IJMOK/StairTreeChoir/README.md

# Stair Tree Choir

Fourteen lip-syncing pixel Christmas trees cut from old spiral-stair oak treads. Each tree has its own ESP32 (WLED); each site has one Pi running FPP that plays the audio and streams the frames over Wi-Fi.

The project brief, decisions and milestones are in [CLAUDE.md](CLAUDE.md). The parts list is in [docs/bom.md](docs/bom.md), the step-by-step build in [docs/build-guide.md](docs/build-guide.md) and the tests in [docs/test-checklist.md](docs/test-checklist.md). What lives where, in this repo and in the xLights show folder, is in [docs/folders.md](docs/folders.md).

## Quick start

```
python -m venv .venv
.venv/Scripts/python -m pip install -r requirements.txt
.venv/Scripts/python -m pip install -r requirements-cad.txt   # optional: the STEP files for CAM
.venv/Scripts/python -m tools.build     # regenerate data/ and cad/
.venv/Scripts/python -m pytest -q
```

Edit `data/blank.json` (the tread outline) or the parameters in `tools/tree_layout.py`, then rebuild. Never edit generated files by hand.
