IJMOK/StairTreeChoir/electronics/README.md

# Tree controller and site wiring (M4)

One controller per tree: an ESP32 dev board running WLED, a 74AHCT125 level shifter and a Mini560 5V buck on a 5×7cm prototype board, in a printed L base + wrap-round cover (`enclosure/tree-box.scad`) on spacers on the back of the tree. The board takes 12V and gives out one 5V data line. The pixels' own 12V never runs through the board.

- [tree-controller-board.svg](tree-controller-board.svg): where every part goes, plus the joins on the underside (mirrored, as you see it when soldering).
- [connections.md](connections.md): the same as a list: every part's holes, and every join with its hole names.

Both are generated by `tools/gen_controller.py` (`make all`). Change the generator, not the files.

## Schematic

```
   (fused 3A at the site box)
12V flex + ───────────────┬──────────────────────────────► pixel string +12V (xConnect)
(SP16)                    │                    Wago 221
                          │
                          └── Mini560 IN+ (wired)            Mini560 OUT+ (90° header) ── 5V rail
12V flex − ───────────────┬──────────────────────────────► pixel string GND
                          └── Mini560 IN− (wired)            Mini560 OUT− (90° header) ── GND rail

5V rail ── ESP32 5V (J2.19) ── U1.14 VCC ── C1 100µF ── C2 0.1µF (at U1) ── GND rail

ESP32 IO16 (J3.12) ──┬── U1.2 (1A)      U1.3 (1Y) ── R1 33Ω ── JD DATA ──► pixel string DATA
                     └── R2 10k ── GND
U1.1 (1/OE) ── GND                       (channel 1 always enabled)
U1.4, 5, 9, 10, 12, 13 ── GND            (spare channels tied off)
U1.6, 8, 11 ── open                      (spare outputs)
ESP32 GND (J3.1) ── GND rail
```

Why each part is there:
- **74AHCT125**: the ESP32 gives 3.3V logic; WS2811 pixels on 12V want close to 5V. An AHCT part powered at 5V reads 3.3V as a clean high. Soldered in (no sockets, Rob 28 Oct 2026), so check the 5V rail before it goes in.
- **R1 33Ω**: damps ringing on the data lead.
- **R2 10k pull-down**: holds the data line low while the ESP32 boots, so the tree doesn't flash random colours at power-on.
- **C1 100µF, C2 0.1µF**: bulk and local decoupling for the 5V rail.
- **GPIO16**: not a boot strapping pin, works with WLED's LED output, and is what the M0 prototype ran on.
- **GPIO 5, 18, 19, 23 stay free.** They are the ESP32's usual SPI pins for a micro-SD card. If Wi-Fi streaming proves too jittery, a £1 SD breakout wired there keeps the ESPixelStick FPP Remote option open (M0 decision) without new boards.

## Inside the box

- 12V comes in through an SP16 panel socket in the base's shelf (rear nut, firing down); the run from the site box ends in the SP17 cable plug that screws onto it. Short tails go from the socket to the Wagos. It is already fused (3A) at the site box, where the run starts, so the fuse protects the flex as well as the tree. There is no fuse in the tree box.
- Two Wago 221-413 lever connectors split the supply: one joins +12V to the pixel string and to the Mini560's IN+, the other joins GND the same way. No 12V reaches the board. The pixel current (about 2.3A at full white) stays on 18AWG wire and the Wagos, never on the prototype board.
- The pixel lead leaves through the PG7 gland in the base's shelf, as a short round tail ending in an xConnect plug, where it meets the tree's own lead. Its data wire goes to JD DATA. JD GND is spare: fit the optional TVS diode across JD (DATA to GND) if you use one.
- The Mini560 stands on its OUT end at the column A edge (Rob, 30 Oct 2026), on a 90 degree header in column C: OUT+ into C4 and C5, OUT- into C8 and C9, using both pads of each pair for strength. That assumes the pads sit on the 2.54 grid: check before soldering. Its IN end, now at the top, is wired directly from the Wagos.
- The ESP32 and U1 are soldered straight in (no sockets, Rob 28 Oct 2026); a dead one means a desolder or a new board.
- **Antenna**: the WROOM-32U has a U.FL socket on the module. Use a U.FL to RP-SMA bulkhead pigtail and a small dipole on the base's shelf, firing down, hinged out clear of the box and the plug. 30mm of wet oak between the antenna and the router costs signal, so put the box on the side of the tree that faces the router where you can.

**Confirmed from Rob's photos (30 and 31 Oct 2026):** the board is 24×18 holes; the ESP32 clone's pin order matches J2/J3 and its header rows are 10 holes apart (25.4mm). Seen from the component side with the antenna end left, J3 (GND, IO23 … IO16 … CLK) is the top row, row 3, and J2 (3V3 … 5V) is the bottom row, row 13. The drawing had these swapped until 31 Oct 2026, a mirror image that can't be built: on the first board that put the GND wire on 3V3 and the 5V wire on CLK. Fix a board wired to the old list before it's ever powered.

**Unverified until the parts arrive:**
- xConnect wire colours (which is data). Check against the arrows on the string and with a meter before connecting anything.
- The Mini560's pad spacing, and which end is IN (check before any power: 12V on OUT kills it).

## Power and USB: never both

Espressif's DevKitC guide says to power the board from exactly one source: USB, *or* the 5V pin, *or* the 3V3 pin. On this board the 5V pin is always fed by the Mini560, so:
- update WLED over Wi-Fi (Config → Security & Updates → Manual OTA), which needs no cable;
- if you must use USB, unplug the 12V first.

## Building and testing one board

1. Solder the terminals and the passives. Don't fit the ESP32, U1 or the Mini560 yet.
2. Do the underside joins from connections.md, ticking them off. Bridges are a solder blob between neighbouring holes; everything else is insulated wire.
3. Continuity check: 12V, 5V and GND are not shorted to each other. No 12V on the board at all: it reaches only the Mini560's IN pads, by wire from the Wagos.
4. Fit the Mini560 on its 90 degree header, OUT end down. Bench supply at 12V, current limit 200mA, into its IN pads. Check 5.0V (±0.1V) at the J2.19 and U1.14 holes. A Mini560 of the wrong voltage version shows here, before it can kill an ESP32.
5. Power off. Solder in U1 (notch to the right, towards R1) and the ESP32 on its own pins (antenna end left). Power on: the ESP32's LED lights and WLED joins Wi-Fi; current should sit under 150mA at 12V.
6. Connect the pixel string through the Wagos and JD. First-light test in WLED (solid red, then green, then blue) to confirm the colour order; then the xLights test chase to confirm node 1 and the wiring order match the model.

Full-white current per tree and the soak test belong in docs/test-checklist.md (M6).

## Site wiring

Decided 26 Oct 2026 (Rob): one enclosed Mean Well LRS PSU per site (Site A uses Rob's S-400-12 instead, 30 Oct 2026), inside the site box (a DRiBOX Large), star-wired from it; no outdoor PSUs. **Per-site tables and diagrams: [site-wiring.md](site-wiring.md)** (generated from data/sites.json). Drawings of how it all connects and where each part sits in the site box and tree box: [docs/wiring.html](../docs/wiring.html) (open it in a browser).

```
Mains (RCD socket) ── plug lead (3A fuse) ──┐
                    Site box (DRiBOX Large) │
                      PSU (A: S-400-12)            ── 12V ─┬─ 3A fuse ── 2-core flex ──◄► Tree box ── pixels   (one run per tree)
                                                            ├─ 3A fuse ── 2-core flex ──◄► Tree box ── pixels
                                                            ├─ 2A fuse ── site router
                                                            └─ 3A fuse ── 12V→5V buck ── Pi (FPP) ── USB sound card ── PAM8610 ══ speaker pair (L, R)
                                                                                          │ Ethernet
                                                                                     Site router ·····Wi-Fi·····► every tree's ESP32 (DDP)
                                                                         ◄► = SP16/SP17 2-pin screw-terminal aviation connector
```

- One LRS per site, the smallest that carries it at no more than 90% with every tree at its cap, plus the player (1.5A) and the router (1A): Site A LRS-200-12 (17A) at 15.1A, B LRS-150-12 at 10.9A, C and D LRS-100-12 at 6.7A. One spare LRS-200-12 covers any site. Enclosed and fanless; it sits at the top of the plate with air round it, and its mains terminals are under a printed cover.
- Each tree's WLED brightness limiter (`ledma` 25, `maxpwr` 2120 incl. WLED's 120mA ESP allowance; tools/gen_site_config.py) holds its pixels to 2A, so a tree draws 2.1A whatever a sequence does (2.3A would be full white). Check it with a meter at the M0 bench test.
- Voltage drop: 2.1A over 5m of 0.75mm² flex (10m of conductor, ~0.23Ω) is about 0.5V, so a tree sees ~11.5V; fine for 12V pixels. The generator moves a run to 1.5mm² past about 7m.
- The fuse (a blade fuse in the site box's fuse box) sits where each run starts, so it protects the flex (a fuse at the tree end would not). 0.75mm² flex is good for ~6A. 3A fuses (Rob, 26 Oct 2026): a tree can't draw more than 2.3A even with no limiter, and the SP17 connectors are 10A.
- Mains reaches only the PSU's covered terminals, on its own lead; never a printed box. The player runs off a Mini560 (5V) after its 3A fuse: Site A's Pi 3 needs 2.5A at most. A Pi 5 would need 5A.
