IJMOK/StairTreeChoir/docs/folders.md

# Where things are

## This repo

"Generated" means `python -m tools.build` (or the named tool) writes it: change the input and rebuild, never edit it by hand.

| Folder | What's in it | Edited by |
|---|---|---|
| `CLAUDE.md`, `README.md` | Project brief and decisions; quick start | hand |
| `cad/` | STEP solids for CAM in NX (tree, fixture plate, assembly); `printed/` every printed part as a STEP solid, as fitted; `stair-tree-kit.step` one tree with boots, pegs and disks (no tree box yet); `components/` and `tree-box-assembly.step` the tree box parts as fitted; 2D CNC layout of one tree (`.svg`) | generated (`tools/gen_step.py`, `tools/gen_printed.py`, `tools/gen_components.py`, `tools/gen_cnc.py`) |
| | The CAM set: `tree.prt`, `fixture-plate.prt`, `Clamp.prt`, `stair-tree-assembly_step.prt`, `stair-tree.gcode` | Rob, in NX |
| `data/` | `blank.json` (tread outline), `sites.json`, `voices.json` | hand |
| | `tree-layout.json` | generated (`tools/tree_layout.py`) |
| | `xlights-effects.json` (effect settings keys) | generated (`tools/xl_keys.py` from the xLights source) |
| `data/songs/` | One arrangement per sequence: who sings each line, looks per section, paths to its show-folder files | hand; `skit-*.json` generated by `tools/skit.py` |
| `data/skits/` | Skit scripts (who says what) | hand |
| `data/loops/` | One arrangement per silent loop piece (Waiting, Night, Morning, Lights Out): background and the characters' moves | generated by `tools/loops.py` |
| `docs/` | BOM, build guide, CNC cutting, test checklist, show night, research, notes | hand |
| `electronics/` | Tree controller board and connections; site wiring | `README.md` hand; `connections.md`, `site-wiring.md`, `*.svg` generated |
| `enclosure/` | Tree box and PSU terminal cover (OpenSCAD) and their STLs | `.scad` hand; `.stl` exported from them |
| `feet/` | The parked boots and peg (OpenSCAD), STLs, previews | `.scad` hand; `.stl`/`.png` exported |
| `fixtures/` | CNC hold-down clamp and pixel disks (OpenSCAD) and STLs | `.scad` hand; `.stl` exported |
| `fpp/` | Per-site FPP config: `site-x/` outputs, playlists, schedule | `README.md` hand; `site-*/` generated (`tools/gen_site_config.py`) |
| `photos/` | Photos of the treads, for measuring | as taken |
| `tests/` | pytest suite (`python -m pytest -q`) | hand |
| `tools/` | Every generator and helper (`python -m tools.<name>`) | hand |
| `wled/` | WLED config per tree, `stairtree-01..14.json`; `provisioned.csv`, the flashed boards | `README.md` hand; configs generated |
| `xlights/` | `StairTree.xmodel` and the xLights notes | `.xmodel` generated (`tools/gen_xmodel.py`); `README.md` hand |
| `archive/` | Superseded work, kept for reference: old NX imports, the printed site box, one-off notes ([archive/README.md](../archive/README.md)). Nothing reads it; `tools/make_public.py` leaves it out | not edited |

Not in git: `previews/` (GIFs from `tools/preview_render.py`), `.venv/`, and everything in the xLights show folder below (lyrics and audio are copyrighted).

## The xLights show folder (`Documents\xLights`)

**Naming rule:** every file of a song shares its sequence name, the name FPP's playlists use. Skits use their script name (`data/skits/<name>.json`). Paths in `data/songs/*.json` are relative to the show folder.

| Where | What |
|---|---|
| top level | Sequences: `<Sequence name>.xsq` (xLights) and `.fseq` (render, uploaded to FPP); xLights' own `.xbkp` backups beside them. xLights and FPP expect them here. Also the layout and controllers (`xlights_rgbeffects.xml`, `xlights_networks.xml`), `user_dictionary` (extra lip-sync words), `Background.jpg`. `tools.xsq` and `tools.xl_timing add` leave a `.xsq.bak` beside the sequence they edit; move old ones to `_Archive`. |
| `Audio\Songs\` | Per song: `<Sequence name>.mp3`, `.lyrics.txt`, `.lrc` (if LRCLIB had one), `.beats.json`, `.timing.json` (word timing for the xLights timing track). E.g. `Feliz Navidad.mp3` … `Feliz Navidad.timing.json` for `Feliz Navidad.xsq`. |
| `Audio\Skits\` | Per skit: `<name>.wav`, `.lyrics.txt`, `.beats.json`, `.timing.json`; sequence `Skit <name>`. `Goodnight` also uses `goodnight.*`. |
| `Audio\Loops\` | `Waiting.timing.json`, `Waiting.beats.json`: the empty lyric timing and the steady beat grid every silent loop piece uses (Waiting, Night, Morning, Lights Out; tools/loops.py). |
| `_Archive\` | Old test sequences, screenshots, old `.xsq.bak` copies. Nothing there is used. |
| `Voices\` | Piper voice models for the skits. |
| `RenderCache\`, `Backup\` | xLights' own caches and backups. |
| `palettes\`, `colorcurves\`, `valuecurves\` | xLights presets. |

Inside a sequence the timing tracks keep short names (`FelizNavidad`, `Skit_tuning_up`; `lyrics_track` in the arrangement), not the file names.

Old names before the 24 Oct 2026 tidy: [show-folder-moves.md](../archive/docs/show-folder-moves.md).
