IJMOK/StairTreeChoir/photos/PXL_20261020_180309936.jpg

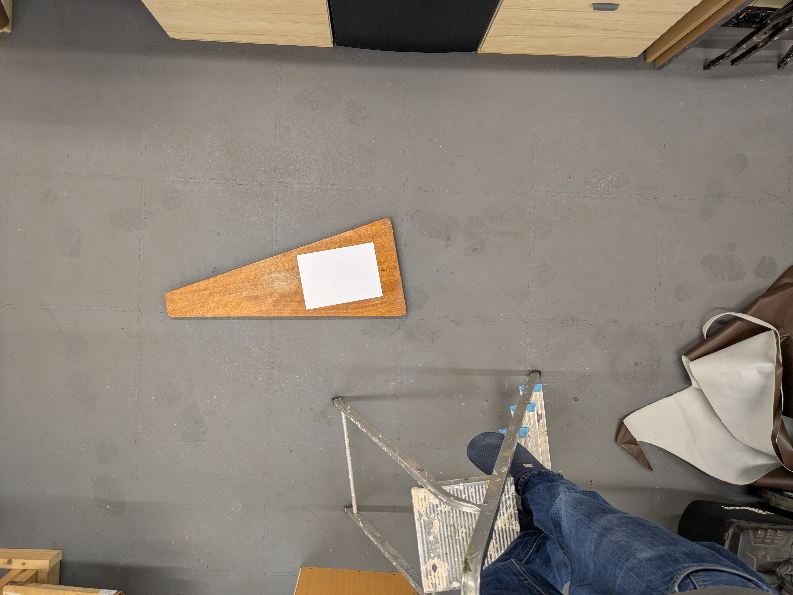
photos/PXL_20261020_180309936.jpg
