IJMOK/StairTreeChoir/photos/PXL_20261020_180347632.jpg

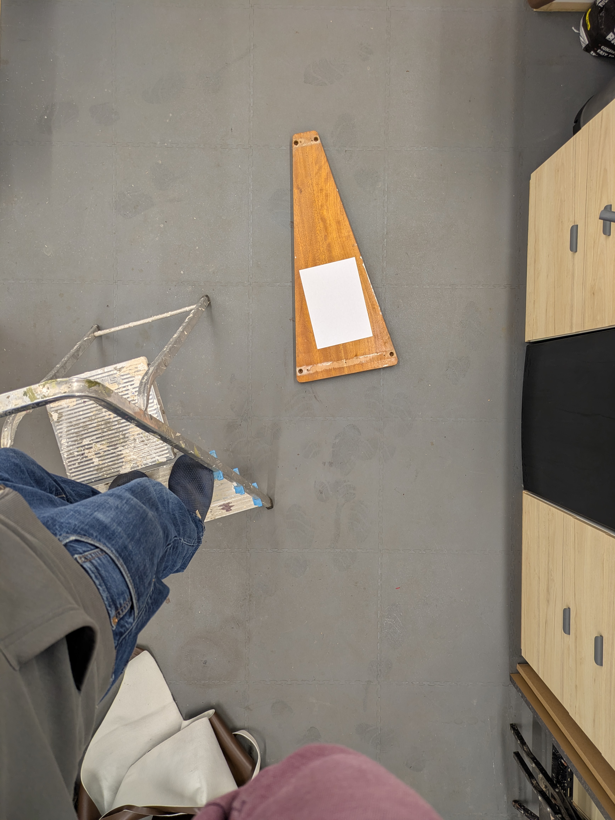
photos/PXL_20261020_180347632.jpg
