IJMOK/StairTreeChoir/cad/tree-box-assembly.step

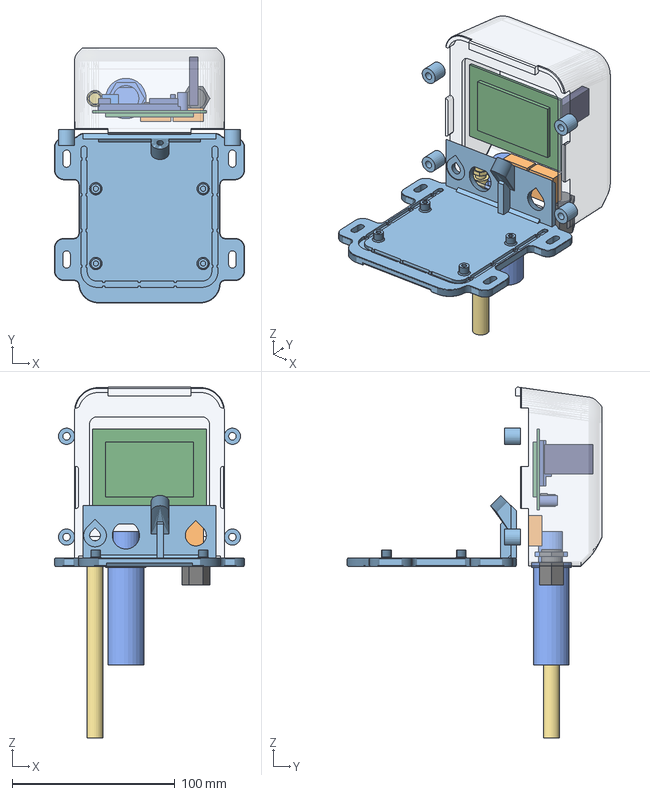
[picture p5: CAD file, 2026-10-31]
cad/tree-box-assembly.step
117.0 x 156.7 x 215.9 mm
tree-box-base
tree-box-cover
protoboard
esp32
u1
terminal
c1
mini560
wago x 2
spacer1 x 4
sp16
pg7
rpsma
