IJMOK/StairTreeChoir/cad/stair-tree-assembly.step

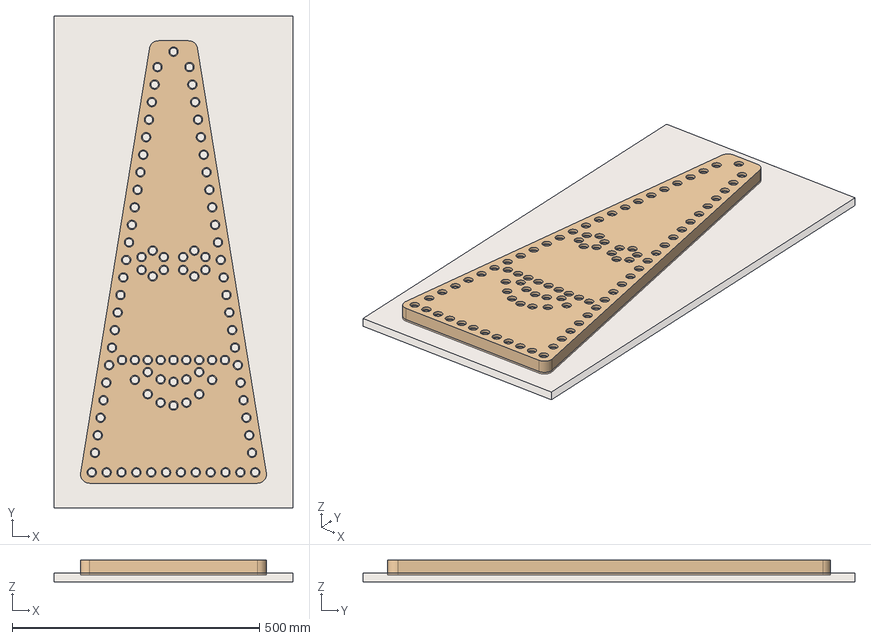
[picture p6: CAD file, 2026-10-27]
cad/stair-tree-assembly.step
482.0 x 994.0 x 44.0 mm
tree
fixture-plate
