IJMOK/StairTreeChoir/cad/components/mini560.step

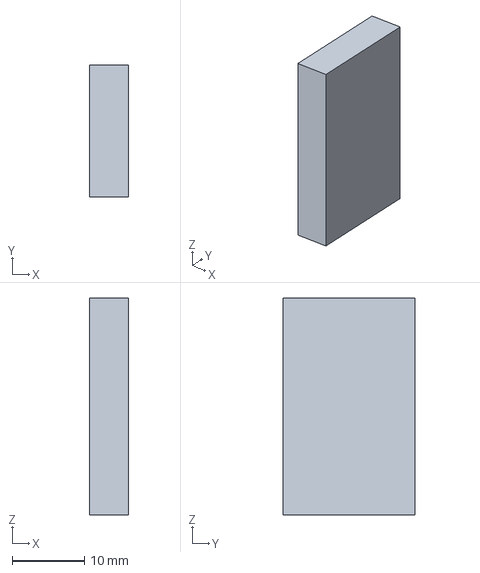
[picture p7: CAD file, 2026-10-30]
cad/components/mini560.step
5.40 x 18.3 x 30.0 mm
