IJMOK/StairTreeChoir/cad/printed/tree-box-base.step

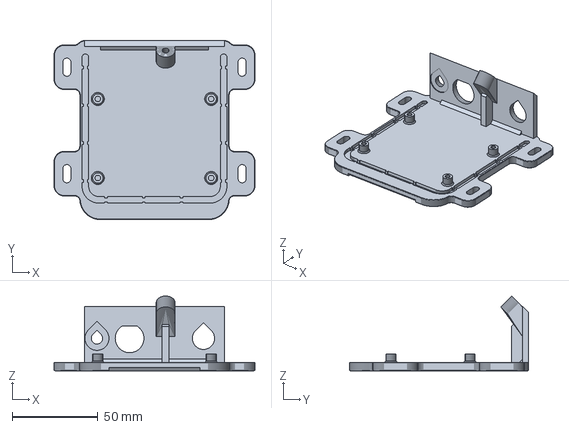
[picture p8: CAD file, 2026-10-31]
cad/printed/tree-box-base.step
117.0 x 104.3 x 43.6 mm
