IJMOK/StairTreeChoir/cad/tree-box-baseNH.stp

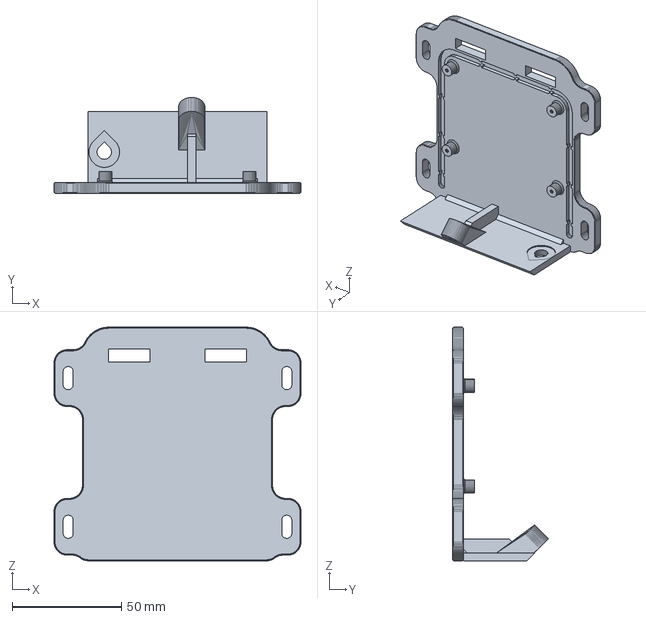
[picture p9: CAD file, 2026-10-31]
cad/tree-box-baseNH.stp
113.0 x 44.0 x 106.9 mm
