IJMOK/StairTreeChoir/feet/stair-tree-foot-left.stl

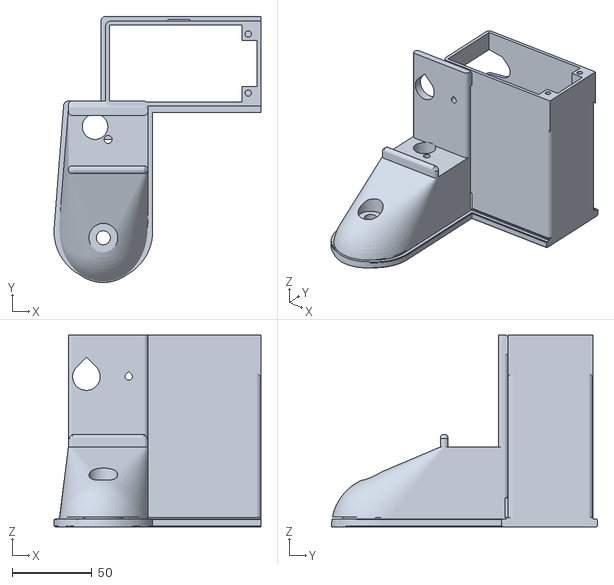
[picture p10: CAD file, 2026-10-28]
feet/stair-tree-foot-left.stl
129.6 x 166.6 x 120.1
