IJMOK/StairTreeChoir/fixtures/pixel-disk-test.stl

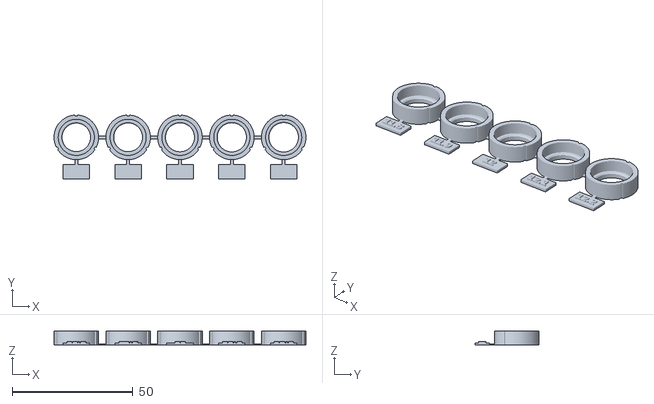
[picture p11: CAD file, 2026-10-27]
fixtures/pixel-disk-test.stl
104.5 x 26.5 x 6.00
