IJMOK/StairTreeChoir/cad/components/terminal.step

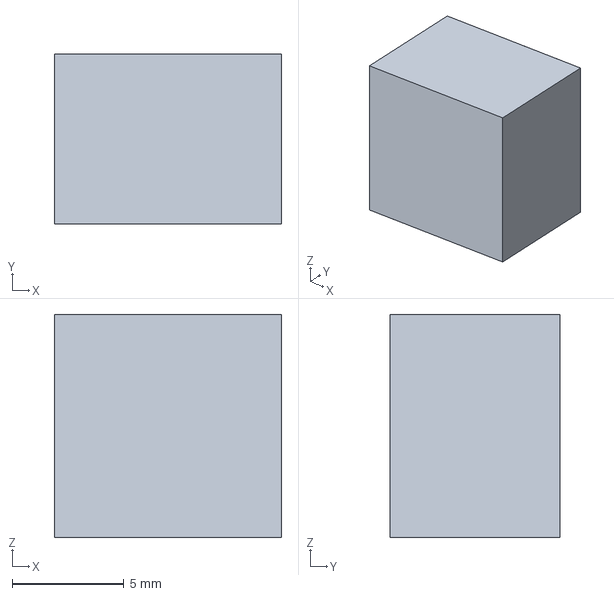
[picture p12: CAD file, 2026-10-30]
cad/components/terminal.step
10.2 x 7.60 x 10.0 mm
