IJMOK/StairTreeChoir/cad/printed/tree-box-cover.step

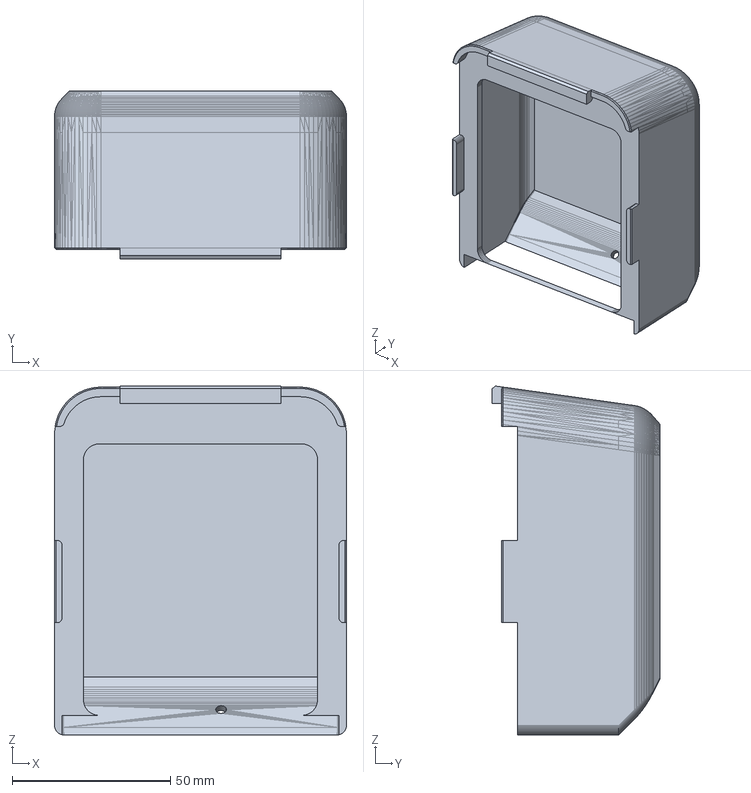
[picture p13: CAD file, 2026-10-31]
cad/printed/tree-box-cover.step
92.3 x 53.0 x 110.3 mm
