IJMOK/StairTreeChoir/feet/stair-tree-foot-right.stl

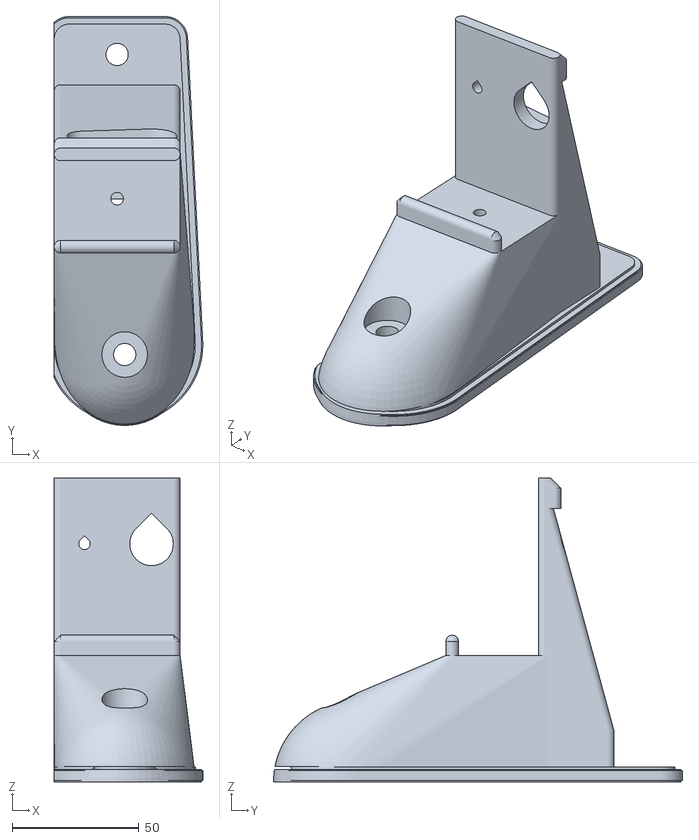
[picture p14: CAD file, 2026-10-27]
feet/stair-tree-foot-right.stl
58.8 x 161.6 x 120.1
