IJMOK/StairTreeChoir/cad/components/esp32.step

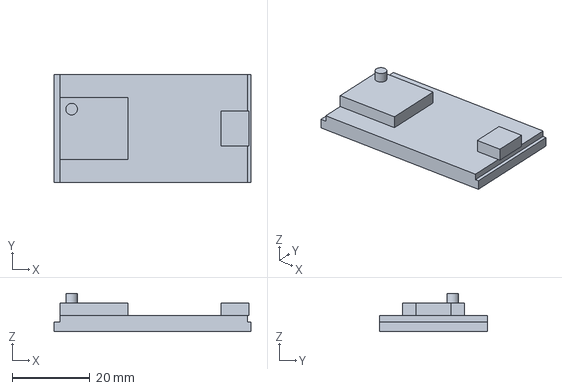
[picture p15: CAD file, 2026-10-30]
cad/components/esp32.step
50.8 x 27.9 x 9.80 mm
