IJMOK/StairTreeChoir/cad/printed/psu-cover.step

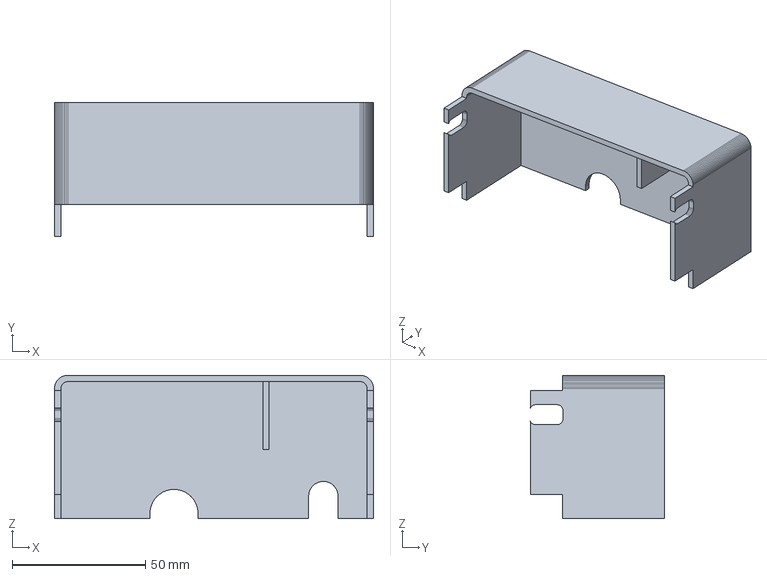
[picture p16: CAD file, 2026-10-30]
cad/printed/psu-cover.step
119.6 x 50.4 x 53.8 mm
