IJMOK/StairTreeChoir/cad/stair-tree-kit.step

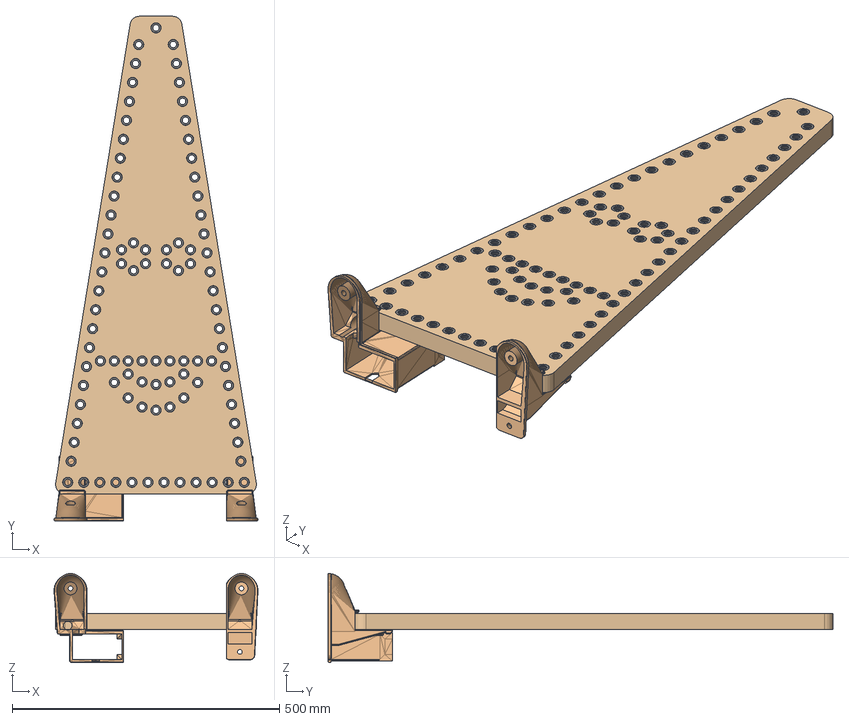
[picture p17: CAD file, 2026-10-28]
cad/stair-tree-kit.step
381.6 x 944.0 x 166.6 mm
tree
boot-left
peg-left
boot-right
peg-right
pixel-disk-01 x 92
