IJMOK/StairTreeChoir/enclosure/tree-box-seal-test.stl

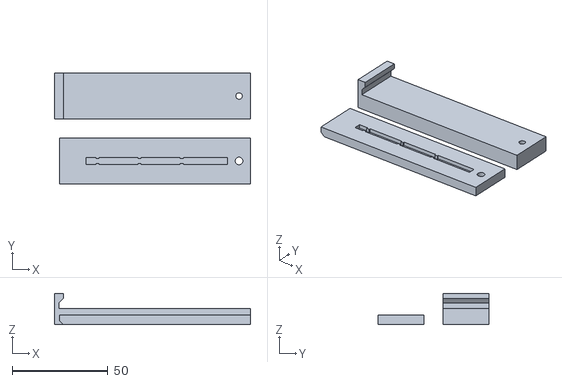
[picture p18: CAD file, 2026-10-31]
enclosure/tree-box-seal-test.stl
102.6 x 58.0 x 16.4
