IJMOK/StairTreeChoir/feet/stair-tree-peg.stl

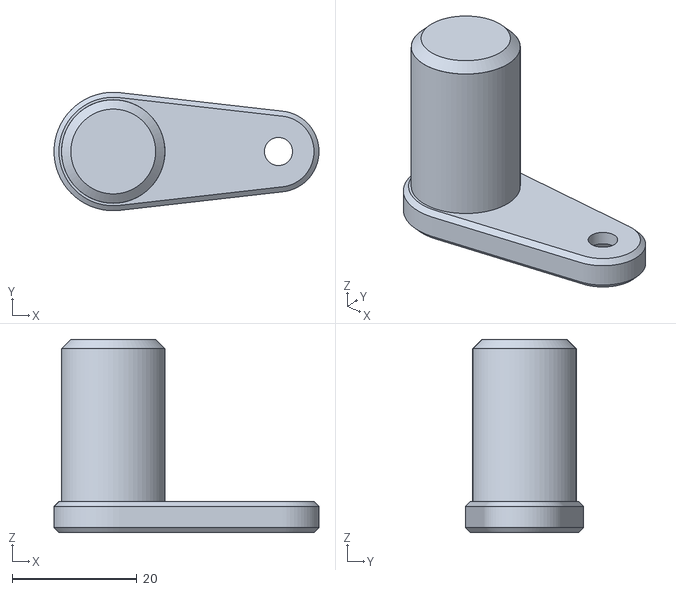
[picture p19: CAD file, 2026-10-27]
feet/stair-tree-peg.stl
42.5 x 19.0 x 31.0
