IJMOK/StairTreeChoir/fixtures/step-clamp.stl

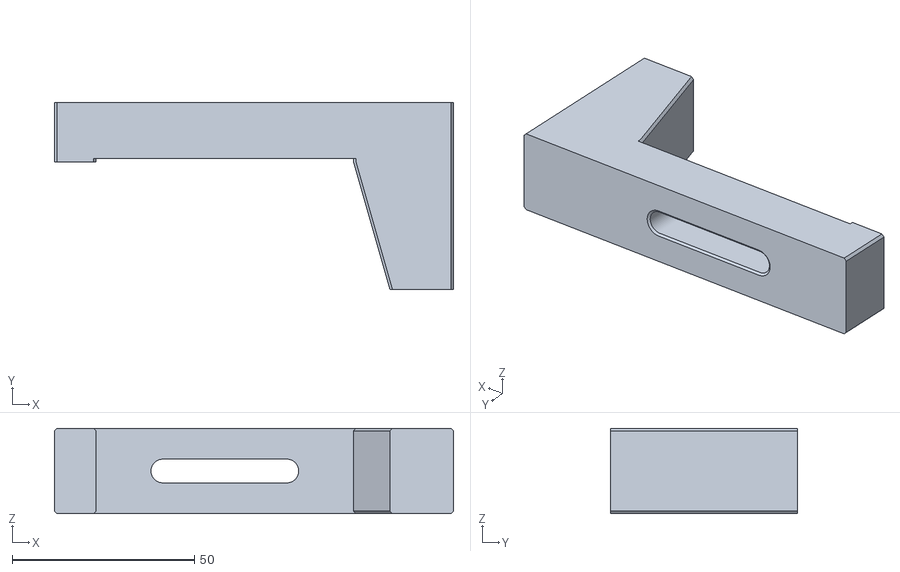
[picture p20: CAD file, 2026-10-27]
fixtures/step-clamp.stl
109.4 x 51.4 x 23.4
