IJMOK/StairTreeChoir/cad/components/rpsma.step

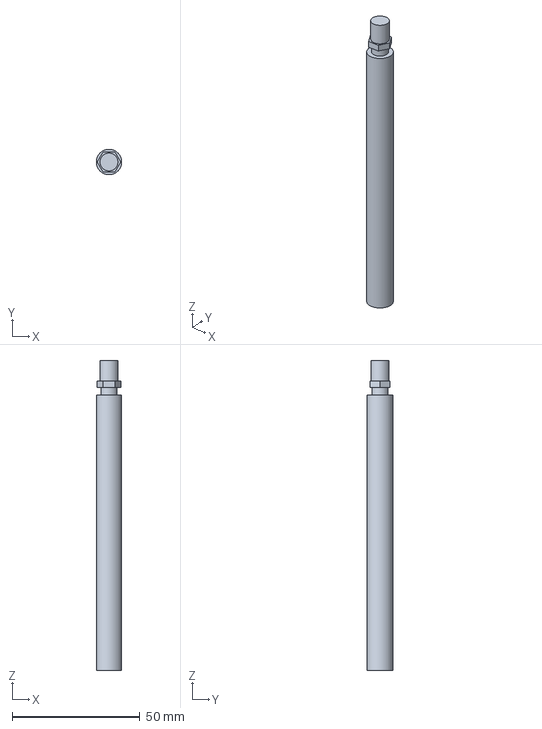
[picture p21: CAD file, 2026-10-30]
cad/components/rpsma.step
9.99 x 10.00 x 121.5 mm
