IJMOK/StairTreeChoir/enclosure/tree-box-coupon.stl

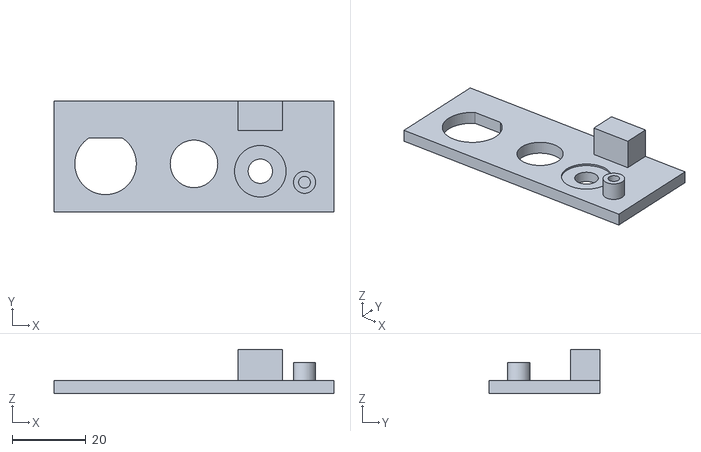
[picture p22: CAD file, 2026-10-31]
enclosure/tree-box-coupon.stl
76.0 x 30.0 x 12.0
