IJMOK/StairTreeChoir/fixtures/pixel-disk.stl

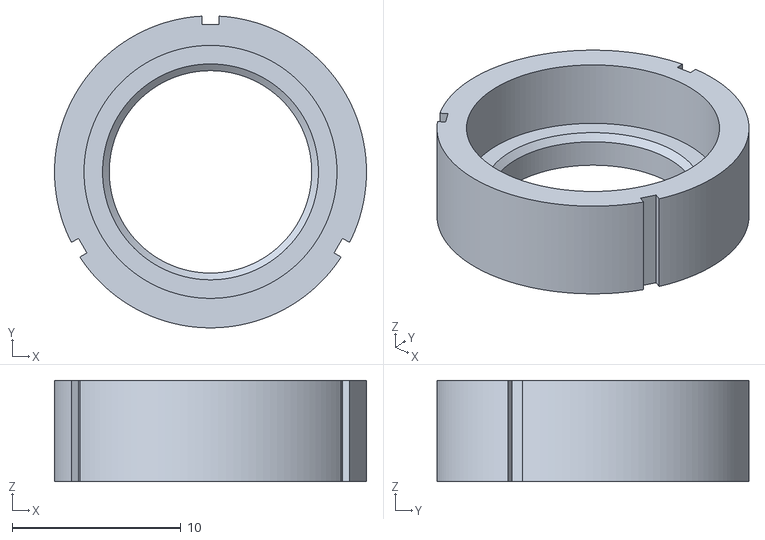
[picture p23: CAD file, 2026-10-27]
fixtures/pixel-disk.stl
18.5 x 18.5 x 6.00
