IJMOK/StairTreeChoir/cad/components/spacer.step

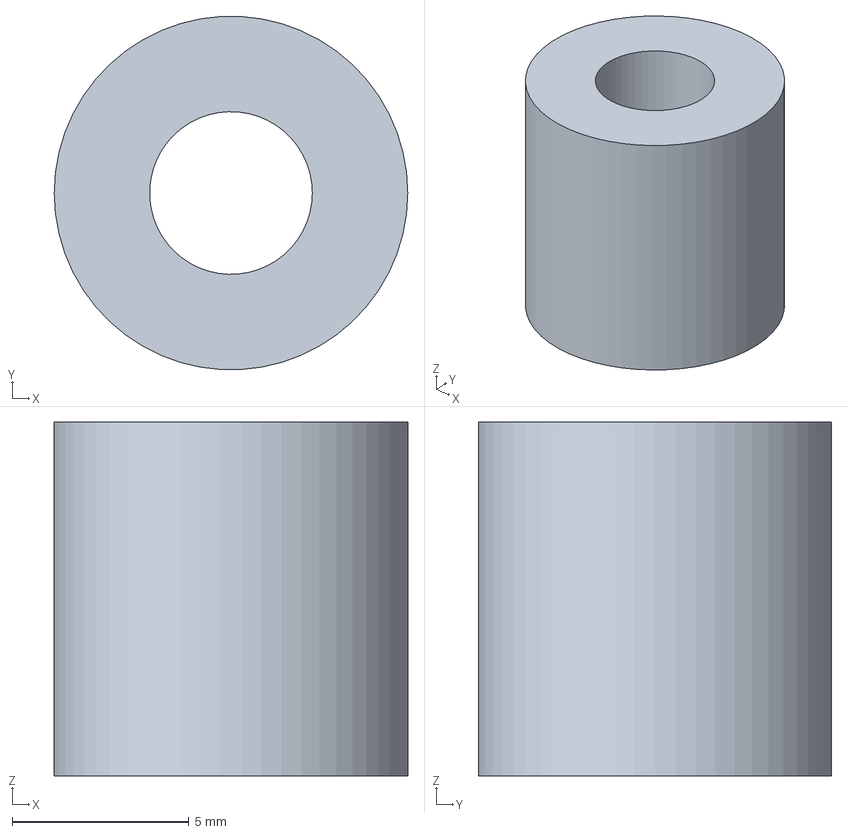
[picture p24: CAD file, 2026-10-30]
cad/components/spacer.step
10.0 x 9.98 x 10.0 mm
