IJMOK/StairTreeChoir/cad/stair-tree.step

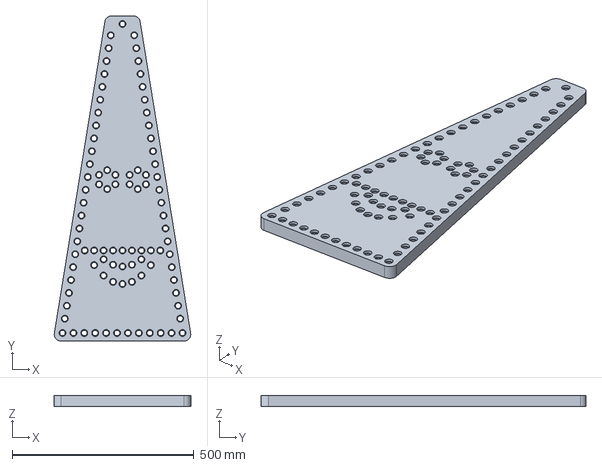
[picture p25: CAD file, 2026-10-27]
cad/stair-tree.step
375.7 x 894.0 x 30.0 mm
