IJMOK/StairTreeChoir/cad/Clamp.stp

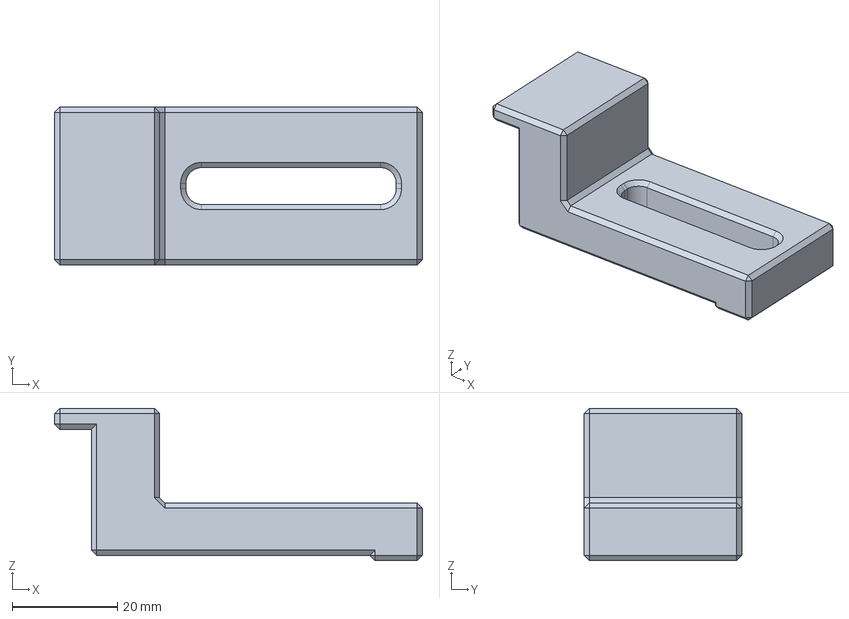
[picture p26: CAD file, 2026-10-25]
cad/Clamp.stp
70.0 x 30.0 x 29.0 mm
