IJMOK/StairTreeChoir/cad/components/u1.step

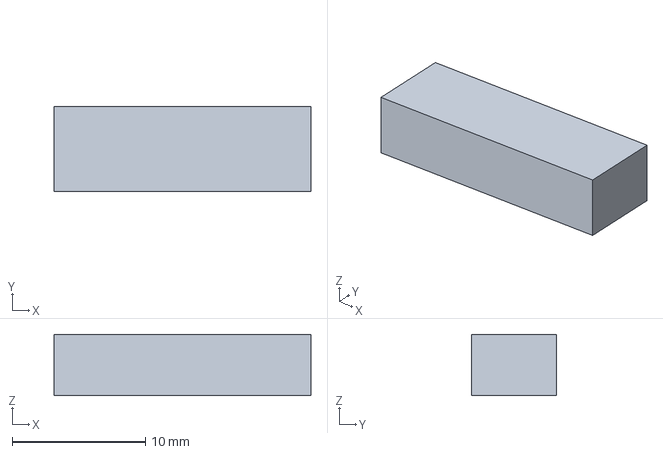
[picture p27: CAD file, 2026-10-28]
cad/components/u1.step
19.3 x 6.35 x 4.60 mm
