IJMOK/StairTreeChoir/enclosure/tree-box-spacer.stl

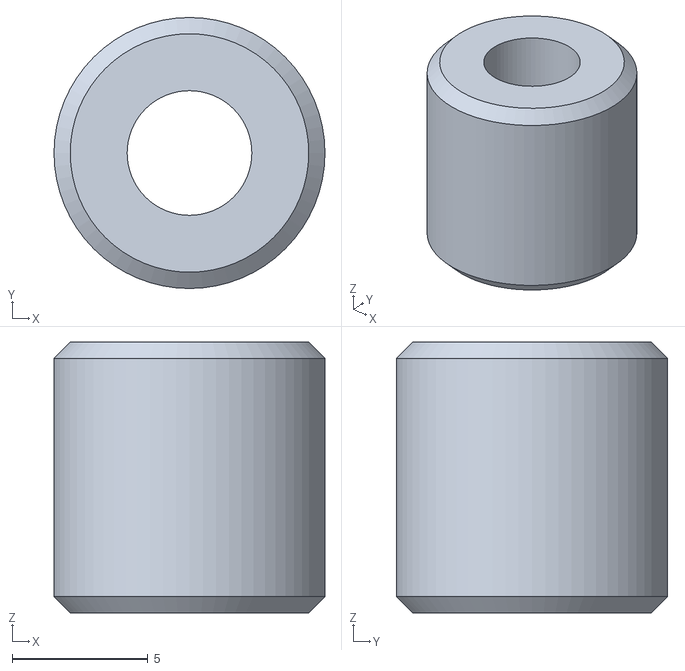
[picture p28: CAD file, 2026-10-30]
enclosure/tree-box-spacer.stl
10.0 x 10.0 x 10.0
