IJMOK/StairTreeChoir/cad/components/sp16.step

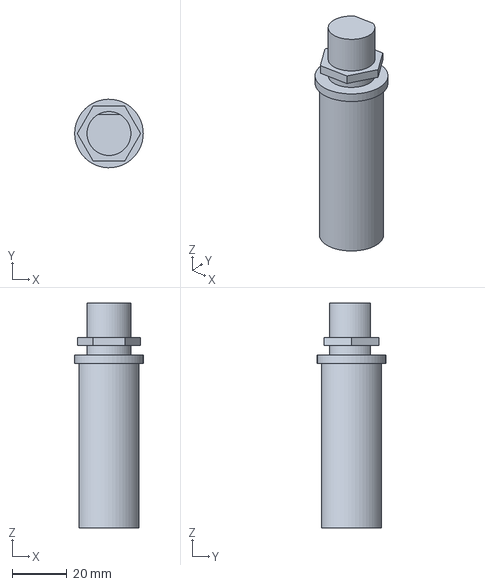
[picture p29: CAD file, 2026-10-28]
cad/components/sp16.step
25.0 x 25.0 x 82.0 mm
