IJMOK/StairTreeChoir/cad/fixture-plate.step

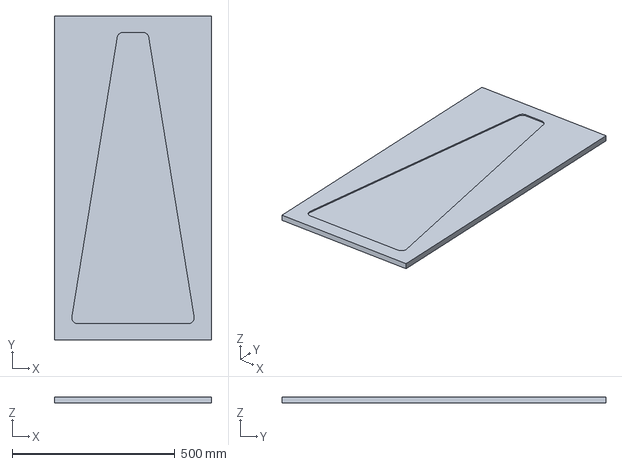
[picture p30: CAD file, 2026-10-25]
cad/fixture-plate.step
482.0 x 994.0 x 18.0 mm
