IJMOK/StairTreeChoir/enclosure/site-box-2-trees.stl

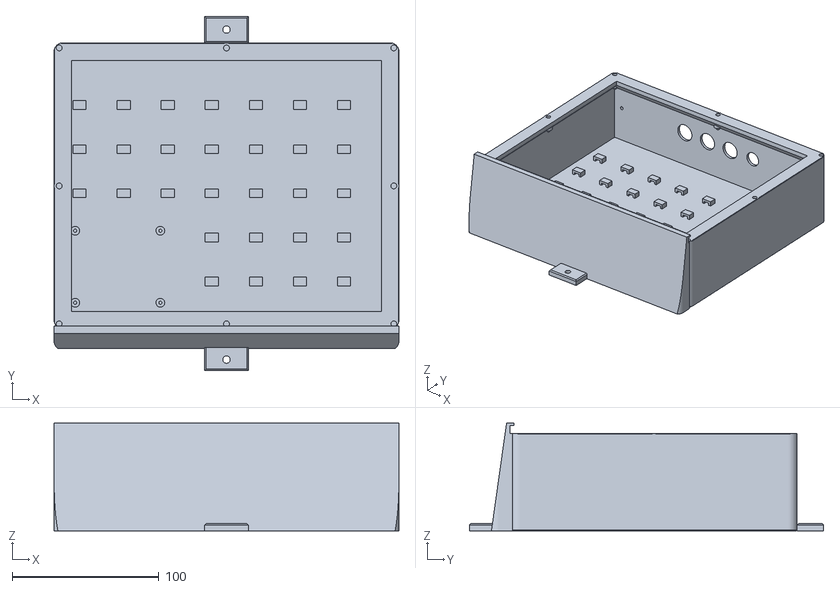
[picture p31: CAD file, 2026-10-27]
enclosure/site-box-2-trees.stl
234.8 x 241.1 x 73.4
