IJMOK/StairTreeChoir/cad/components/wago.step

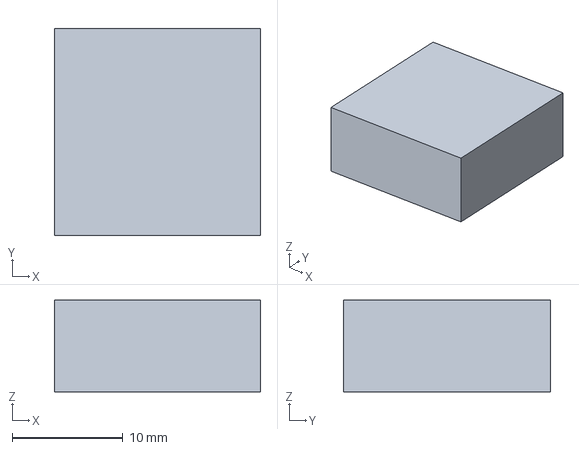
[picture p32: CAD file, 2026-10-28]
cad/components/wago.step
18.6 x 18.7 x 8.30 mm
