IJMOK/StairTreeChoir/cad/components/c1.step

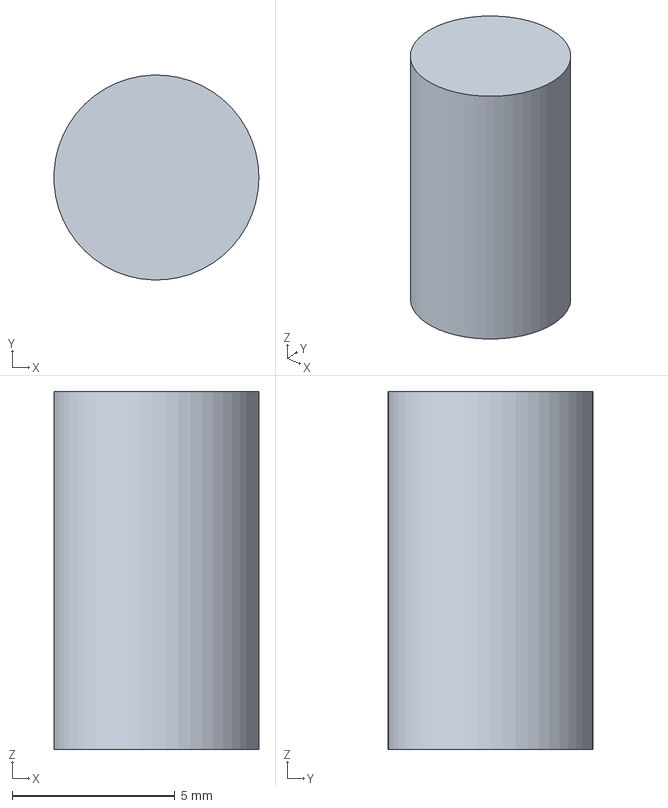
[picture p33: CAD file, 2026-10-28]
cad/components/c1.step
6.29 x 6.30 x 11.0 mm
