IJMOK/StairTreeChoir/enclosure/site-box-lid.stl

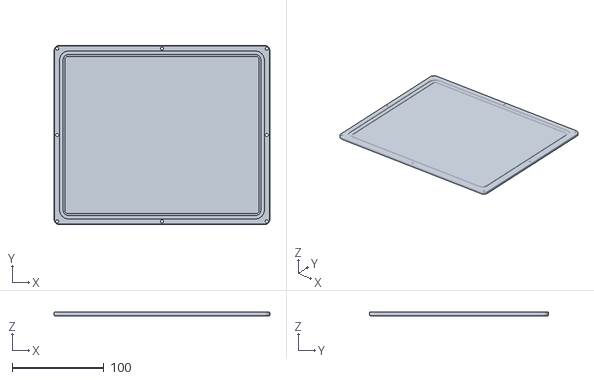
[picture p34: CAD file, 2026-10-27]
enclosure/site-box-lid.stl
234.8 x 194.8 x 4.00
