IJMOK/StairTreeChoir/cad/components/pg7.step

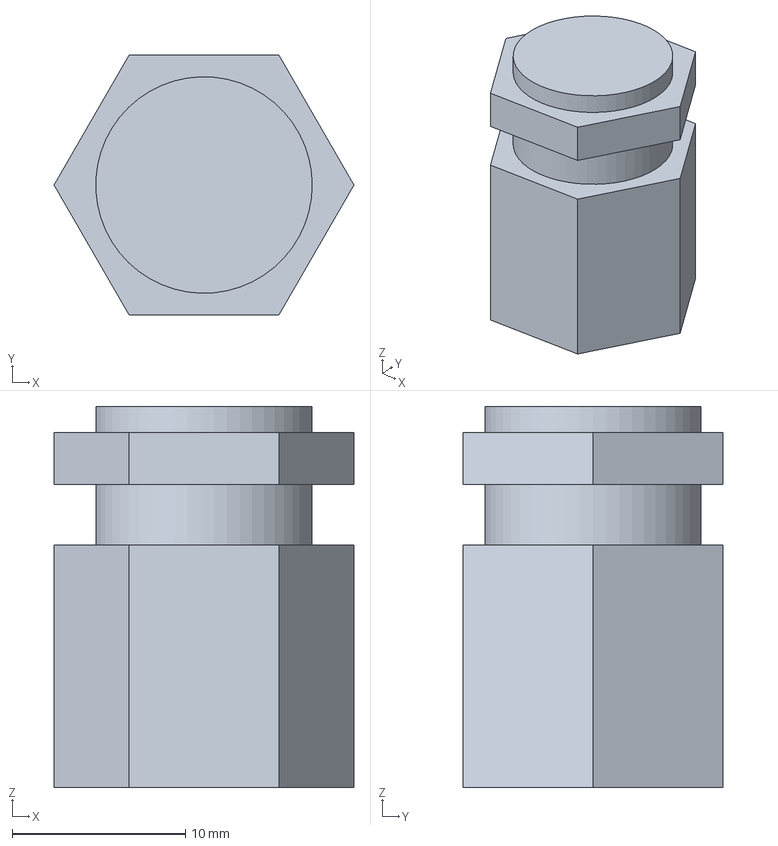
[picture p35: CAD file, 2026-10-28]
cad/components/pg7.step
17.3 x 15.0 x 22.0 mm
