IJMOK/StairTreeChoir/cad/components/protoboard.step

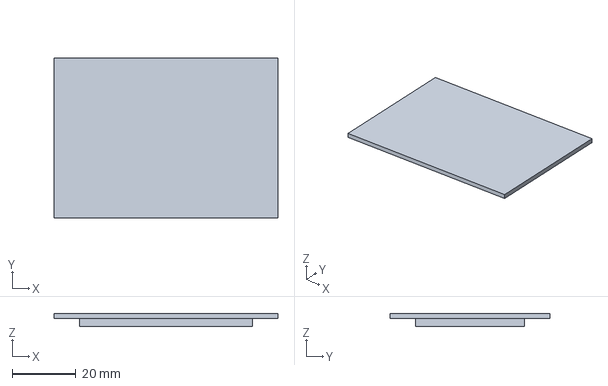
[picture p36: CAD file, 2026-10-28]
cad/components/protoboard.step
70.0 x 50.0 x 4.10 mm
