IJMOK/StairTreeChoir/enclosure/site-box.scad

// Site box (M3): the show player and the 12V distribution for one site.
// An upright wall box on the shared sealed-box shell (sealed-box.scad): lid on the
// front, every cable through the floor, rounded corners, and a hollow roof sloping
// away from the post with a hood and drip lip over the lid joint. Screw it to a post
// or fence through the lugs (the top one stands clear of the roof), under some cover
// if you can.
//
// Inside, on the back wall: the Pi (standoffs on the Raspberry Pi 58 x 49mm M2.5
// pattern, Pi 3 and Pi 5 alike), and a grid of zip-tie anchors for everything whose
// size isn't confirmed yet: site router (Cudy WR3000), 12V->5V buck, PAM8610, USB sound card,
// and per PSU a pair of Wago 221-413s and its inline blade fuse holders.
//
// Wiring (electronics/site-wiring.md): the Mean Well PSUs stand OUTSIDE, one per pair
// of trees; mains never enters this box. Each PSU's 12V comes in on its own gland
// and feeds only its own fuses (never parallel two PSUs). PSU 1 also feeds the
// player through a 3A fuse. One gland out per tree, one for the speaker.
//
// Floor glands, left to right: PSU inputs, tree runs, speaker (PG7). Unused tree
// holes for smaller sites: export with trees = 4 or 2.
//
// Printing (P1S, 255mm bed): box on its back, open side up, no supports; lid flat,
// outer face down. Outside 235 x 195mm. Lid sealed with 2.7mm rubber cord (seal.scad).
//
// UNVERIFIED: PG9/PG7 thread sizes, M3 insert hole, that everything fits the
// 64mm depth with the router on its side. Lay the real parts out on the back wall
// before printing.

include <sealed-box.scad>

part   = "assembly";     // "box", "lid", "assembly"; "box-fitted", "lid-fitted": as fitted (STEP export)
trees  = 6;              // glands for this many tree runs (6, 4 or 2)
psus   = ceil(trees / 2);

in_w     = 230;          // inside, across
in_h     = 190;          // inside, up
in_d     = 64;           // inside, back wall to rim
wall     = 2.4;
rim      = 12;           // rim width at the lid face: lid screws, then the cord groove
lid_t    = 4;
lid_panel_t = 2;
corner_r = 6;
groove_in = 8;           // cord groove centreline from the outer edges

pg9_d    = 15.6;
pg7_d    = 12.9;
gland_pitch = 25;        // PG9 locknut is ~22mm across corners
drip_d   = 3;

pi_holes = [[0, 0], [58, 0], [0, 49], [58, 49]];   // Raspberry Pi mounting holes, M2.5
pi_at    = [12, in_h - 12 - 49 - 3.5];              // first hole, from the inside bottom-left
standoff_h = 6;

anchor_pitch = 30;       // zip-tie anchors on the back wall
anchor_slot  = [5, 2.2]; // tie width x thickness it takes

m3_clear = 3.4;
m3_insert_d = 4.0;
m3_insert_len = 6;
screw_in = 3.5;          // lid screw centres from the outer edges
boss_d   = 7;
boss_len = 12;
lug_w    = 30;
lug_t    = 5;
lug_hole = 5;            // for a 4.5mm screw into the post

$fn = 40;

W = in_w + 2 * wall;
H = in_h + 2 * wall;
D = wall + in_d;          // back face to rim face
lid_screws = [for (x = [screw_in, W / 2, W - screw_in]) for (z = [screw_in, H - screw_in]) [x, z]];
side_screws = [for (x = [screw_in, W - screw_in]) [x, H / 2]];
all_screws = concat(lid_screws, side_screws);

// Box coordinates: x across, z up (as fitted), y from the back face (0) to the rim (D).
module along_y(d, l) { rotate([-90, 0, 0]) cylinder(d = d, h = l); }

module zip_anchor() {        // a bridge on the back wall a cable tie threads under
    difference() {
        translate([-(anchor_slot[0] + 4) / 2, 0, -3]) cube([anchor_slot[0] + 4, anchor_slot[1] + 2, 6]);
        translate([-anchor_slot[0] / 2, -1, -4]) cube([anchor_slot[0], anchor_slot[1] + 1, 8]);
    }
}

function in_pi(x, z) = x > wall + pi_at[0] - 12 && x < wall + pi_at[0] + 58 + 12
                    && z > wall + pi_at[1] - 12 && z < wall + pi_at[1] + 49 + 12;

gland_list = concat([for (i = [0 : psus - 1]) pg9_d], [for (i = [0 : trees - 1]) pg9_d], [pg7_d]);
gland_rows = len(gland_list) * gland_pitch > in_w - 10 ? 2 : 1;

roof_top = H + sb_hood_gap + sb_skin + sb_rise(D + lid_t + sb_hood_over);   // at the back face
lug_top_h = roof_top - H + lug_w * 0.5;                                       // top lug clears the roof

module box() {
    difference() {
        union() {
            sb_shell(W, H, D, wall, wall, wall, rim, corner_r, lid_t);
            intersection() {
                rprism(W, H, D, corner_r, 0, 0);
                for (s = all_screws) translate([s[0], D - boss_len, s[1]]) {
                    along_y(boss_d, boss_len);
                    translate([0, -boss_d / 2, 0]) rotate([-90, 0, 0]) cylinder(d1 = 0.1, d2 = boss_d, h = boss_d / 2);
                }
            }
            for (h = pi_holes) translate([wall + pi_at[0] + h[0], wall - 0.01, wall + pi_at[1] + h[1]]) along_y(6, standoff_h);
            for (x = [wall + 15 : anchor_pitch : W - wall - 10]) for (z = [wall + 40 : anchor_pitch : H - wall - 10])
                if (!in_pi(x, z)) translate([x, wall - 0.01, z]) zip_anchor();
            // wall-mounting lugs on the back face: below the floor, and above the roof
            lug(-lug_w * 0.6, lug_w * 0.6);
            lug(H - 1, lug_top_h + 1);
        }
        for (s = all_screws) translate([s[0], D - m3_insert_len, s[1]]) along_y(m3_insert_d, m3_insert_len + 1);
        for (h = pi_holes) translate([wall + pi_at[0] + h[0], wall - 1, wall + pi_at[1] + h[1]]) along_y(2.2, standoff_h + 1);
        for (z = [-lug_w * 0.3, H + lug_top_h - lug_w * 0.25]) translate([W / 2, -1, z]) along_y(lug_hole, lug_t + 2);
        // floor glands, in one or two rows
        for (i = [0 : len(gland_list) - 1]) {
            per_row = ceil(len(gland_list) / gland_rows);
            r = floor(i / per_row); c = i % per_row;
            x = W / 2 + (c - (per_row - 1) / 2) * gland_pitch;
            y = wall + (gland_rows == 1 ? in_d / 2 : (r == 0 ? in_d * 0.3 : in_d * 0.72));
            translate([x, y, -1]) cylinder(d = gland_list[i], h = wall + 2);
        }
        translate([wall + 8, wall + in_d / 2, -1]) cylinder(d = drip_d, h = wall + 2);
    }
}

module lug(z0, h) {             // tab on the back face, edges chamfered
    translate([W / 2 - lug_w / 2, 0, z0]) hull() {
        cube([lug_w, lug_t - 1, h]);
        translate([1, 0, 1]) cube([lug_w - 2, lug_t, h - 2]);
    }
}

module lid() { sb_lid(W, H, lid_t, lid_panel_t, corner_r, all_screws, groove_in); }

if (part == "box") rotate([90, 0, 0]) box();   // back face on the bed, open side up
else if (part == "lid") lid();
else if (part == "box-fitted") box();
else if (part == "lid-fitted") translate([0, D + lid_t, 0]) rotate([90, 0, 0]) lid();
else {
    color("SteelBlue") box();
    color("LightSteelBlue", 0.5) translate([0, D + lid_t, 0]) rotate([90, 0, 0]) lid();
}
