IJMOK/StairTreeChoir/fixtures/step-clamp.scad

// Printed hold-down clamp for the CNC bed's channel-strut rails (41mm strut, ~180mm
// centres; one tree per setup, two to four clamps). The bolt goes into a strut
// spring/channel nut.
// A bar with a nose that presses on the tread's edge and a heel that rests on the bed;
// the M6 bolt goes through the slot between them, nearer the nose so most of the force
// lands on the work. PETG, printed on its side (slot vertical) so the layers run along
// the bar and don't split under the bolt.
//
// Rob's bed (23 Oct 2026): MDF topper with 41x21 lipped steel strut (Unistrut type,
// 2.5mm wall) set in grooves, strut top ~4mm below the topper; M6 bolts into strut channel nuts. The tread sits on a sacrificial
// sheet (the holes go through), the heel stands on the topper beside it.
// Bolt length: printed with the clamp's console echo (M6 x that, or the next size up).

part = "clamp";          // "clamp" or "washer"; "clamp-fitted": the right way up (STEP export)

bolt_d     = 6.5;        // M6 clearance
tree_t     = 30;         // tread
spoil_t    = 6;          // sacrificial sheet under the tread (set to yours)
strut_drop = 4;          // strut top below the topper
strut_lip  = 2.5;        // strut wall: the channel nut sits under the lips
nut_t      = 6;          // M6 spring channel nut
work_h     = tree_t + spoil_t;   // top of the tread above the topper
bar_l      = 110;
bar_w      = 24;
bar_t      = 16;         // bar thickness above the work
nose_l     = 12;         // grip on the work: keep <= 10-12mm, the counterbores start ~12.5mm in
nose_pad   = 1;          // nose stands proud, so the bar tilts onto the work, not the heel
heel_l     = 18;
slot_from_nose = 30;     // slot starts this far from the nose end
slot_len   = 34;         // adjustment along the bar
washer_od  = 18;
washer_t   = 4;

$fn = 48;

// head on the washer, through the bar, down the groove, past the lip, through the nut
echo(bolt_len = ceil(washer_t + bar_t + work_h + strut_drop + strut_lip + nut_t));

ch = 1;                  // edge bevel all round (Minkowski with a coarse sphere)

module clamp() {
    difference() {
        minkowski() {
            union() {           // every block shrunk by ch, then grown back with bevelled edges
                translate([ch, ch, work_h + ch]) cube([bar_l - 2 * ch, bar_w - 2 * ch, bar_t - 2 * ch]);
                translate([ch, ch, work_h - nose_pad + ch]) cube([nose_l - 2 * ch, bar_w - 2 * ch, nose_pad + ch]);
                hull() {        // heel, 45 degree inside face so it prints on its side
                    translate([bar_l - heel_l + ch, ch, ch]) cube([heel_l - 2 * ch, bar_w - 2 * ch, work_h]);
                    translate([bar_l - heel_l - 10 + ch, ch, work_h]) cube([heel_l + 10 - 2 * ch, bar_w - 2 * ch, 0.01]);
                }
            }
            sphere(r = ch, $fn = 4);   // a coarse sphere: bevels every edge
        }
        // bolt slot, chamfered at the top for the washer
        hull() for (x = [slot_from_nose, slot_from_nose + slot_len])
            translate([x, bar_w / 2, work_h - 1]) cylinder(d = bolt_d, h = bar_t + 2);
        hull() for (x = [slot_from_nose, slot_from_nose + slot_len])
            translate([x, bar_w / 2, work_h + bar_t - 0.8]) cylinder(d1 = bolt_d, d2 = bolt_d + 2, h = 0.81);
        // grip ridges under the nose
        for (x = [2:3:nose_l - 2]) translate([x, -1, work_h - nose_pad - 0.6]) rotate([0, 45, 0]) cube([1, bar_w + 2, 1]);
    }
}

module washer() {
    difference() {
        hull() {            // edges chamfered
            cylinder(d = washer_od - 1.6, h = washer_t);
            translate([0, 0, 0.8]) cylinder(d = washer_od, h = washer_t - 1.6);
        }
        translate([0, 0, -1]) cylinder(d = bolt_d, h = washer_t + 2);
    }
}

if (part == "clamp") rotate([-90, 0, 0]) translate([0, -bar_w, 0]) clamp();   // on its side
else if (part == "clamp-fitted") clamp();
else washer();
