IJMOK/StairTreeChoir/(list of files, cad)

Other CAD files:
enclosure/tree-box-base.stl
enclosure/tree-box-cover.stl
cad/printed/boot-left.step
cad/printed/boot-right.step
enclosure/psu-cover.stl
cad/printed/peg-left.step
cad/printed/site-box-6-trees.step
enclosure/site-box-6-trees.stl
cad/printed/site-box-4-trees.step
cad/printed/site-box-2-trees.step
enclosure/site-box-4-trees.stl
cad/printed/site-box-lid.step
cad/printed/peg-right.step
cad/printed/pixel-disk.step
cad/printed/step-clamp.step
archive/nx-imports/fixture-plate_step.prt
archive/nx-imports/stair-tree-cnc-layout_dxf.prt
archive/nx-imports/stair-tree_step.prt
archive/nx-tree-box/1-box-and-lid-28oct/c1.prt
archive/nx-tree-box/1-box-and-lid-28oct/esp32.prt
archive/nx-tree-box/1-box-and-lid-28oct/header.prt
archive/nx-tree-box/1-box-and-lid-28oct/mini560.prt
archive/nx-tree-box/1-box-and-lid-28oct/pg7.prt
archive/nx-tree-box/1-box-and-lid-28oct/protoboard.prt
archive/nx-tree-box/1-box-and-lid-28oct/rpsma.prt
archive/nx-tree-box/1-box-and-lid-28oct/sp16.prt
archive/nx-tree-box/1-box-and-lid-28oct/terminal.prt
archive/nx-tree-box/1-box-and-lid-28oct/tree-box-assembly.prt
archive/nx-tree-box/1-box-and-lid-28oct/tree-box-box.prt
archive/nx-tree-box/1-box-and-lid-28oct/tree-box-lid.prt
archive/nx-tree-box/1-box-and-lid-28oct/u1.prt
archive/nx-tree-box/1-box-and-lid-28oct/wago.prt
archive/nx-tree-box/2-sliding-cover-28oct/c1134118.prt
archive/nx-tree-box/2-sliding-cover-28oct/esp32131607.prt
archive/nx-tree-box/2-sliding-cover-28oct/mini560134235.prt
archive/nx-tree-box/2-sliding-cover-28oct/pg7136021.prt
archive/nx-tree-box/2-sliding-cover-28oct/protoboard130936.prt
archive/nx-tree-box/2-sliding-cover-28oct/rpsma137192.prt
archive/nx-tree-box/2-sliding-cover-28oct/sp16134938.prt
archive/nx-tree-box/2-sliding-cover-28oct/terminal133439.prt
archive/nx-tree-box/2-sliding-cover-28oct/tree-box-base.prt
archive/nx-tree-box/2-sliding-cover-28oct/tree-box-cover.prt
archive/nx-tree-box/2-sliding-cover-28oct/u1133090.prt
archive/nx-tree-box/2-sliding-cover-28oct/wago134584.prt
archive/nx-tree-box/3-clip-on-cover-30oct/c1541770.prt
archive/nx-tree-box/3-clip-on-cover-30oct/esp32539259.prt
archive/nx-tree-box/3-clip-on-cover-30oct/mini560541887.prt
archive/nx-tree-box/3-clip-on-cover-30oct/pg7543673.prt
archive/nx-tree-box/3-clip-on-cover-30oct/protoboard538588.prt
archive/nx-tree-box/3-clip-on-cover-30oct/rpsma544844.prt
archive/nx-tree-box/3-clip-on-cover-30oct/sp16542590.prt
archive/nx-tree-box/3-clip-on-cover-30oct/terminal541091.prt
archive/nx-tree-box/3-clip-on-cover-30oct/tree-box-assembly10.prt
archive/nx-tree-box/3-clip-on-cover-30oct/tree-box-base80.prt
archive/nx-tree-box/3-clip-on-cover-30oct/tree-box-cover295239.prt
archive/nx-tree-box/3-clip-on-cover-30oct/u1540742.prt
archive/nx-tree-box/3-clip-on-cover-30oct/wago542236.prt
archive/printed-site-box/sealed-box.scad
archive/printed-site-box/site-box-2-trees.step
archive/printed-site-box/site-box-4-trees.step
archive/printed-site-box/site-box-4-trees.stl
archive/printed-site-box/site-box-6-trees.step
archive/printed-site-box/site-box-6-trees.stl
archive/printed-site-box/site-box-lid.step
cad/Clamp.prt
cad/c1.prt
cad/c1134118.prt
cad/c1541770.prt
cad/esp32.prt
cad/esp32131607.prt
cad/esp32539259.prt
cad/fixture-plate.prt
cad/fixture-plate_step.prt
cad/header.prt
cad/mini560.prt
cad/mini560134235.prt
cad/mini560541887.prt
cad/pg7.prt
cad/pg7136021.prt
cad/pg7543673.prt
cad/printed/step-clamp-washer.step
cad/protoboard.prt
cad/protoboard130936.prt
cad/protoboard538588.prt
cad/rpsma.prt
cad/rpsma137192.prt
cad/rpsma544844.prt
cad/sp16.prt
cad/sp16134938.prt
cad/sp16542590.prt
cad/stair-tree-assembly_step.prt
cad/stair-tree-cnc-layout_dxf.prt
cad/stair-tree_step.prt
cad/terminal.prt
cad/terminal133439.prt
cad/terminal541091.prt
cad/tree-box-assembly.prt
cad/tree-box-assembly10.prt
cad/tree-box-base.prt
cad/tree-box-base80.prt
cad/tree-box-box.prt
cad/tree-box-cover.prt
cad/tree-box-cover295239.prt
cad/tree-box-lid.prt
cad/tree.prt
cad/u1.prt
cad/u1133090.prt
cad/u1540742.prt
cad/wago.prt
cad/wago134584.prt
cad/wago542236.prt
fixtures/step-clamp-washer.stl
