IJMOK/StairTreeChoir/docs/wiring.html

Stair Tree Choir · Site A, December 2026 · plan as of 30 Oct (tree box: L base + clip-on cover)

# How the power, sound and data go together

One mains plug feeds one power supply in the site box. Every tree gets its own fused 12V run and a plug-in connector. The trees get their show over Wi-Fi, so the only cable to a tree is power.

230V mains +12V 0V 5V pixel data audio network

## 1 · What connects to what

Everything at Site A runs from one S-400-12. The blade fuse box gives each tree its own 3A fuse, plus 3A for the player (Pi and amp). Every run leaves on 2-core 0.75mm² rubber flex (H05RR-F) and ends in an SP17 aviation plug with screw terminals, so there's nothing to solder. It screws onto the SP16 socket under the tree box's shelf. Full load is 14.1A of 33A. The router stands indoors at the front window, about 5ft from the trees, on its own adapter, with Ethernet out to the Pi.

## 2 · Inside the site box

Seen from above with the lid open, to scale (1 square = 10mm). The DRiBOX narrows towards the floor and has ribs, so plan on about 290 × 190mm of flat floor. The parts sit on one printed plate. The plate isn't designed yet.

Mains goes only from the cord grip to the PSU's terminals, under a printed cover (hatched), so it takes a tool to reach them. The S-400-12's terminals, facing them, left to right: ADJ, +V × 3, −V × 3, earth, N, L. Its input switch is set to 230V and its fan is temperature-controlled, so keep air above it. The cover is held by two M4 screws in the case's side holes. Everything else is 12V or lower. The PSU's +12V and 0V go to the fuse box: +12V to its input, 0V to its negative bus. The player fuse feeds the Mini560 (5V for the Pi) and the amp. Sizes for the fuse box and amp are typical, not measured.

## 3 · At each tree

The tree box stands on four 10mm spacers on the back of the tree, low down on the node 1 side. An L base carries everything, including the three fittings firing down through its shelf, so nothing unplugs when the cover comes off. The cover hooks in at the top, swings in and takes one M3 screw at the bottom.

Two Wagos split the 12V: one side feeds the pixels directly, the other is wired straight to the Mini560's IN end, at the top as it stands. Its OUT end plugs into the board on a 90° header and gives 5V to the ESP32 and level shifter. No 12V reaches the board. Pixel current never crosses the board. Data leaves JD and goes out through the PG7 gland with the pixel power. There's no fuse in the tree box, because the run is fused at the site box. The cord seals the top and sides; the bottom is left open on purpose, because rain doesn't fall upwards.

## What sits where

Part | Size | Sits | Fed from
S-400-12 | 217 × 114 × 50 | Site box, back left, terminals under a printed cover | Mains plug lead (L, N, earth)
Blade fuse box, 10-way | ≤ 150 × 65 (ordered, measure it) | Site box, front left | PSU +12V in; 0V on 2 × Wago 221-415
Pi 3 + USB sound card | 56 × 85 | Site box, back right | Mini560 5V (player fuse, 3A)
PAM8610 amp | ≈ 63 × 40 | Site box, front right | 12V (player fuse, 3A)
Cudy WR3000 V1 router | 183 × 109 × 35 | Indoors at the front window, antennas upright | Its own adapter; outdoor Cat6 to the Pi
Tree run | 5m, H05RR-F 2 × 0.75mm² | Ground, site box to tree | Tree fuse, 3A; SP17 plug onto the tree box's SP16 socket
PD BGO40 speakers (pair) | 130 × 155 × 200 | Outdoors near the trees, IP56 | PAM8610, one 2-core run each (cable in the box)
SP16 panel socket | hole 16.5, flat 15.3 | Tree box shelf, firing down | The run's SP17 plug
PG7 gland | hole 12.9 | Tree box shelf, firing down | Pixel lead out
RP-SMA bulkhead + dipole | hole 6.6 | Tree box shelf, firing down | U.FL pigtail to the ESP32
Controller board | 50 × 70 | Tree box, on 4 standoffs | Mini560 5V, on a 90° header
Mini560 (tree) | ≈ 30 × 18 | Tree box, standing on the board on a 90° header | Wago 12V, wired to its IN end
2 × Wago 221-413 | — | Tree box, below the board | The SP16 socket in the shelf

- Earth the PSU: the mains lead's earth goes to its earth terminal.
- Meter every connector before plugging in: red to +, the same pin every time.
- Tighten each SP17's gland nut on the cable sheath. The cable must be 6–10mm across.
- Keep connector joints off the ground where water pools. They're only waterproof when plugged together.
