IJMOK/StairTreeChoir/tools/gen_cnc.py

"""2D CNC reference from data/tree-layout.json: cad/stair-tree-cnc-layout.svg and .dxf.

The CAM is done in NX from the STEP solids (tools/gen_step.py); these are the
same features flat, for checking and for anyone without NX. Everything is cut
from the front in one op (Rob, 25 Oct 2026): no flip, nothing mirrored.

Layers (same names in both files):
  BLANK              blank outline, front view (sharp corners; the STEP has them rounded)
  FRONT_COUNTERBORE  pixel disk counterbores, front_counterbore_depth deep
  FRONT_HOLES        clearance holes behind the disks, right through
  EXISTING           reference only, do not cut: the old stair fixing holes in the back
"""

from __future__ import annotations

import json
from pathlib import Path

import ezdxf

from tools.tree_layout import LAYOUT_FILE, ROOT

CAD_DIR = ROOT / "cad"
SVG_FILE = CAD_DIR / "stair-tree-cnc-layout.svg"
DXF_FILE = CAD_DIR / "stair-tree-cnc-layout.dxf"


def fmt(v: float) -> str:
    s = f"{v:.2f}".rstrip("0").rstrip(".")
    return "0" if s == "-0" else s


def geometry(layout: dict) -> dict:
    blank, p = layout["blank"], layout["params"]
    return {
        "width": blank["width"],
        "height": blank["height"],
        "blank": [tuple(q) for q in blank["polygon"]],
        "holes": [(n["x"], n["y"]) for n in layout["nodes"]],
        "counterbore_dia": p["front_counterbore_dia"],
        "counterbore_depth": p["front_counterbore_depth"],
        "clearance_dia": p["clearance_dia"],
        "existing": [((h["x"], h["y"]), h["dia"]) for h in blank.get("existing_holes", [])],
    }


def write_svg(g: dict, path: Path = SVG_FILE) -> None:
    w, h = g["width"], g["height"]

    def poly(points):
        return f'<polygon points="{" ".join(f"{fmt(x)},{fmt(y)}" for x, y in points)}"/>'

    def circle(p, d):
        return f'<circle cx="{fmt(p[0])}" cy="{fmt(p[1])}" r="{fmt(d / 2)}"/>'

    def layer(name, label, colour, body, extra=""):
        return [f'<g id="{name}" inkscape:groupmode="layer" inkscape:label="{label}" fill="none" stroke="{colour}" stroke-width="0.5"{extra}>',
                *body, "</g>"]

    lines = [
        '<?xml version="1.0" encoding="UTF-8"?>',
        "<!-- Generated by tools/gen_cnc.py from data/tree-layout.json. Do not edit by hand. -->",
        f'<svg xmlns="http://www.w3.org/2000/svg" xmlns:inkscape="http://www.inkscape.org/namespaces/inkscape" '
        f'width="{fmt(w)}mm" height="{fmt(h)}mm" viewBox="0 0 {fmt(w)} {fmt(h)}">',
        *layer("BLANK", "BLANK", "#000", [poly(g["blank"])]),
        *layer("FRONT_COUNTERBORE", f"FRONT_COUNTERBORE ({fmt(g['counterbore_depth'])} deep)", "#c60",
               [circle(p, g["counterbore_dia"]) for p in g["holes"]]),
        *layer("FRONT_HOLES", "FRONT_HOLES (through)", "#c00", [circle(p, g["clearance_dia"]) for p in g["holes"]]),
    ]
    if g["existing"]:
        lines += layer("EXISTING", "EXISTING (reference only, in the back)", "#999",
                       [circle(p, d) for p, d in g["existing"]], ' stroke-dasharray="2 1"')
    lines.append("</svg>")
    path.write_text("\n".join(lines) + "\n", encoding="utf-8", newline="\n")


def write_dxf(g: dict, path: Path = DXF_FILE) -> None:
    ezdxf.options.write_fixed_meta_data_for_testing = True  # deterministic output
    doc = ezdxf.new("R2010", setup=False)
    doc.units = ezdxf.units.MM
    doc.header["$MEASUREMENT"] = 1
    for name, colour in {"BLANK": 7, "FRONT_COUNTERBORE": 30, "FRONT_HOLES": 1, "EXISTING": 8}.items():
        doc.layers.add(name, color=colour)
    msp = doc.modelspace()

    # DXF is y-up: flip so the drawing reads the same way round as the SVG.
    def up(p):
        return (p[0], g["height"] - p[1])

    msp.add_lwpolyline([up(p) for p in g["blank"]], close=True, dxfattribs={"layer": "BLANK"})
    for p in g["holes"]:
        msp.add_circle(up(p), g["counterbore_dia"] / 2, dxfattribs={"layer": "FRONT_COUNTERBORE"})
        msp.add_circle(up(p), g["clearance_dia"] / 2, dxfattribs={"layer": "FRONT_HOLES"})
    for p, d in g["existing"]:
        msp.add_circle(up(p), d / 2, dxfattribs={"layer": "EXISTING"})
    doc.saveas(path)


def main() -> None:
    g = geometry(json.loads(LAYOUT_FILE.read_text(encoding="utf-8")))
    CAD_DIR.mkdir(exist_ok=True)
    write_svg(g)
    write_dxf(g)
    print(f"wrote {SVG_FILE.relative_to(ROOT)}, {DXF_FILE.relative_to(ROOT)}")


if __name__ == "__main__":
    main()
