IJMOK/StairTreeChoir/(commit log)

2026-10-20 Stair Tree Choir: project brief, BOM and M1 layout + CNC generator
    Layout generator reads the tread outline from data/blank.json (placeholder
    400x900 triangle until measured) and writes the 92-node wiring-order layout;
    gen_cnc writes layered SVG and DXF (front holes, mirrored back channel and
    data-in pocket, spoilboard registration dowels).
    [stair-tree-cnc-layout.dxf]
2026-10-20 Layout from the measured tread; keep clear of the old fixing holes
    Tread measured from the two photos via the A4 sheet: symmetric tapered board,
    ~92mm narrow end, ~382mm wide end, ~894mm long. The four old 17x23mm fixing
    holes in the back (plus pilots) are keep-outs: outline pixels keep a 5mm wall,
    and the back channel detours to keep 3mm from the 17mm holes. CNC files gain an
    EXISTING reference layer.
    [stair-tree-cnc-layout.dxf]
2026-10-20 Data-in pocket 25mm; optional back counterbore for the pixels (size TBC)
    [stair-tree-cnc-layout.dxf]
2026-10-20 Tree feet rough-in: printed PETG foot using the old fixing hole, nailed down
    Spigot into the old 17mm hole, screw into the old pilot, shelf 50mm off the
    grass, front and back wings with 8mm nail holes. Left and right STLs exported.
    [stair-tree-foot-left.stl, stair-tree-foot-right.stl, stair-tree-foot.scad]
2026-10-20 BOM: nails and screws for the printed feet replace steel stakes
2026-10-20 Face option C; feet become hollow printed boots
    Face moved up (eyes 450mm, lip 645mm below the top). Feet redesigned as
    cartoon boots the tree stands in: hollow and open underneath, printed upright
    on a P1S without supports, roughly 140-170g each instead of ~200g+. Fixes the
    v1 screw head being buried with no screwdriver access.
    [stair-tree-cnc-layout.dxf, stair-tree-foot-left.stl, stair-tree-foot-right.stl, stair-tree-foot.scad]
2026-10-20 Boots: toe nail post joins the toe roof (was a loose island in the slicer)
    The head seat was wider than the post, cutting it free of the shell. The post
    is now wider than the seat and fills up to the toe roof. Both STLs checked as
    a single body.
    [stair-tree-foot-left.stl, stair-tree-foot-right.stl, stair-tree-foot.scad]
2026-10-20 Architecture: ESP32 (WLED) on every tree, one FPP player per site
    Replaces the pair-kit design (Pi + GPIO DPI output per two trees). Each tree
    gets its own ESP32 with a short data lead; each site has one Pi running FPP
    that plays audio and streams DDP to its trees over a dedicated site router.
    Adds an M0 prototype milestone, site/tree addressing, and updates the BOM
    (fewer Pis, 14 ESP32s, routers; some bought parts now spare).
2026-10-20 BOM: gland allocation for the ESP32-per-tree design
2026-10-20 M2: xLights custom model generator with face definition and sub-models
    StairTree.xmodel is a 39x90 grid (10mm cells) in wiring order, with a
    NodeRange face definition covering every xLights phoneme, open/closed eyes and
    the outline, and sub-models for each node group. Format taken from the xLights
    source (custommodel/faceInfo/subModel serialisation).
2026-10-21 M0: WLED on the spare ESP32 receives DDP from xLights; setup steps and reference config
2026-10-21 M4: tree controller board layout generator, wiring docs; DIY ESP32-32U boards chosen
2026-10-21 BOM: 6 more level shifters and bucks for 16 boards
2026-10-21 xLights: slot controllers pinned to each tree, Choir group, automation port notes
2026-10-21 Second song: Dominick the Donkey arrangement; lyric timing strips brackets, retries LRCLIB, falls back to LRC timing on failed lines; beats tool
    [beats.py, lyric_timing.py]
2026-10-21 Dominick fixes: singing windows stop at neighbouring lines and merge only across silence; timing tidy (no overlaps, words >= 0.1s); render checker; API retry on 503
    [arrange_song.py, check_render.py, lyric_timing.py]
2026-10-21 make_public: review list skips code matches
    [make_public.py]
2026-10-21 make_public: don't skip prose like 'parents (4 trees)'
    [make_public.py]
2026-10-23 Boots: separate peg (spigot blocked assembly), left control boot carries the controller box on a tower; tree box enclosure; one PSU per site, fuses at the site box
    [stair-tree-foot-left.stl, stair-tree-foot-right.stl, stair-tree-foot.scad, stair-tree-peg.stl, tree-box-box.stl, tree-box-gasket.stl, tree-box-lid.stl, tree-box-params.scad]
2026-10-23 CNC: cutting sheet (holes from the front, flip located from two centreline holes) and printed M6 step clamps for the strut rails
    [step-clamp-washer.stl, step-clamp.scad, step-clamp.stl]
2026-10-23 Step clamp: heel on the MDF topper, tread on a sacrificial sheet, strut 4mm down; bolt length echoed
    [step-clamp.scad, step-clamp.stl]
2026-10-23 Step clamp: bolt length counts the strut lip and the 4mm washer (M6 x 70)
    [step-clamp-washer.stl, step-clamp.scad, step-clamp.stl]
2026-10-23 Site wiring: data/sites.json (defaults 6/4/2/2, 5m runs) and gen_site_wiring (per-site loads, fuses, flex, diagrams); PSU corrected to LPV-100-12 per pair (no LPV-200; LPV-150 is 10A)
    [build.py, gen_site_wiring.py]
2026-10-23 Site box: upright wall box with floor glands per PSU/tree/speaker, Pi standoffs, zip-tie anchor grid; per-PSU fusing (never parallel PSUs)
    [site-box-2-trees.stl, site-box-4-trees.stl, site-box-6-trees.stl, site-box-gasket.stl, site-box-lid.stl, site-box.scad]
2026-10-23 BOM: gland count for the site boxes (15 more PG9)
2026-10-23 Box lids sealed with Rob's 2.7mm rubber cord in a lid groove (seal.scad) instead of TPU gaskets; tree box widened so the 70mm board passes the rim opening
    [seal.scad, site-box-2-trees.stl, site-box-4-trees.stl, site-box-6-trees.stl, site-box-gasket.stl, site-box-lid.stl, site-box.scad, stair-tree-foot-left.stl]
2026-10-23 Design for feel, weather and filament: rounded/chamfered edges, sloped roofs with drip hoods (shared sealed-box shell), sloped boot cuffs, thin lid panels, thinner boot walls; fastener schedule in th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
    [sealed-box.scad, site-box-2-trees.stl, site-box-4-trees.stl, site-box-6-trees.stl, site-box-lid.stl, site-box.scad, stair-tree-foot-left.stl, stair-tree-foot-right.stl]
2026-10-24 Schedule: announcements 16:15-19:45 only (the 19:xx ones announce the 20:00 last show); generator removes playlists it no longer makes
    [gen_site_config.py]
2026-10-24 Waiting loop (300 s, no audio); arrange_song: zero-line arrangements, end_at/end_fade
    data/songs/waiting.json: six gentle 50 s looks for between shows, eyes
    blinking, rolling, sparkling and spinning in turn; empty timing track and a
    0.6 s beat grid in Audio/Loops.
    arrange_song: an arrangement may have no lines (the dry run no longer needs
    one), and "end_at" clips every effect, Faces included, so the frames after it
    are black; "end_fade" fades out the effects that end there. Tests for both.
    [arrange_song.py]
2026-10-24 Goodnight closer: the goodnight skit ending on black (4/4 lines)
    end_at 9.9 s with a 1.2 s fade: the fseq's last 21 frames are all zero, so FPP
    holding the last frame leaves the trees dark.
2026-10-24 Show folder tidy: song files in Audio/Songs named after the sequence
    Each song's audio, lyrics, beats and timing now share its sequence name
    (Audio/Songs/<Sequence name>.*); skit timing is Audio/Skits/<name>.timing.json;
    Frosty parked in Audio/Parked; old test files and .xsq.bak in _Archive.
    Updated data/songs paths, the sequences' media paths (re-rendered all 21,
    every line still matches), FPP playlists' media names, and the tools:
    lyric_timing writes <audio stem>.timing.json (--out replaces --track) and
    finds the show folder from nested Audio dirs; skit.py uses --out;
    xl_timing add drops ".timing" from the default track name. Moves logged in
    docs/show-folder-moves.md; repo and show folder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
    [lyric_timing.py, skit.py, xl_timing.py]
2026-10-24 BOM: 24 Oct deliveries, ESP32/antenna order (10 of 16), status column, RS 159-1490 lid cord
2026-10-24 Site router: Cudy WR3000 on vanilla OpenWrt instead of GL.iNet Mango
    Dual-band WiFi 6 with external antennas for better range to the trees;
    off-season the routers double as home 802.11s mesh nodes. Show stays on
    2.4 GHz, subnet 192.168.8.x (router .1). Placement in/beside the site
    box and 12V power from PSU 1 are still TBC.
    [site-box.scad]
2026-10-24 Arrangements: no mid-line singer handovers without a breath
    Where a sung line is split across two timing segments (a half-line, or a
    cut mid-phrase) and the pause between them is under 0.3s, both halves now
    go to the union of the two groups, so the trees sing it as a duo instead of
    swapping mouths mid-sentence. 18 lines across Dominick, Little Drummer Boy,
    Frosty and O Come All Ye Faithful. Call-and-response with a real breath
    (Rockin', the pa-rum-pum answers, Twelve Days lead-ins) is unchanged.
    Re-arranged, rendered and check_render passes on all four.
2026-10-24 Skits: ElevenLabs voices with per-line direction
    tools/skit.py gains an ElevenLabs engine (eleven_v3, key from
    ELEVENLABS_API_KEY, every clip cached by voice/settings/text so re-runs cost
    no credits); Piper stays as the --engine piper fallback. Cast in voices.json:
    Holly=Alice, Ivy=Lily, Noel=Eric, Jingle=Liam, Bramble=Bill, Pip=Laura,
    picked from measured pitch/pace (auditions kept in the show folder).
    Scripts carry v3 audio tags ([sleepily], [giggles]...), stripped for lip-sync.
    Alignment is now kept inside each line's known span of audio, spreading a
    line's words when Whisper smears or squeezes it (fixed "Bramble!/Present!").
    xl_timing add --replace and xsq --fit-audio refresh a re-voiced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
    [skit.py, xl_timing.py, xsq.py]
2026-10-24 FPP show bundle and show plan; Goodnight follows the re-voiced audio
    tools/fpp_bundle.py gathers a site's config, playlists, rendered .fseq and
    audio from the show folder into Documents\xLights\FPP\<site>\ laid out like
    FPP's media folder, refuses missing or stale renders, writes the night with
    real running times (docs/show-plan.md), and can --deploy over the FPP API
    (unverified until there is a player). Shows run 11:13 to 13:40.
    Goodnight reuses the goodnight skit audio, now 13.4s: end_at moves to 12.4s,
    timing track replaced, length fitted, re-rendered (check_render 4/4).
    [fpp_bundle.py]
2026-10-24 BOM: split still-to-buy into December (Site A, 6 trees) and later
    Adds the site box parts the design uses but the list missed: the
    12V->5V buck for the player and the inline blade fuse holders.
    Fasteners get a December column.
2026-10-24 Specials built: Saturday Special, New Year's Eve countdown, New Year's Day
    - Five New Year songs (Auld Lang Syne with corrected lyrics, Happy New Year,
    What a Wonderful World, Here Comes the Sun, Walking on Sunshine): timing,
    arrangements (no tight mid-line handovers), rendered; 176/176 lines match.
    - 18 new skits: NYE (announce, thank-yous, Bramble staying up / nodding off,
    the midnight countdown, goodnight), New Year's Day (intro, announce,
    thank-you, season goodbye) and Saturday (announcements, teaser closer,
    special intro, Bramble wakes after TWO songs, thank-yous). All render-checked.
    - skit.py: lines for several characters or "Everyone" (voices mixed), "at"
    for exact timing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
    [fpp_bundle.py, gen_site_config.py, lyric_timing.py, skit.py]
2026-10-24 Docs: show webcam scope and BOM (hedge camera, battery, stream with copyright auto-mute)
2026-10-24 Webcam: shows-only live + recorded clips; ESP32 deep-sleep power control replaces the timer
2026-10-25 CNC: one front-only op with printed pixel disks, STEP files for NX
    Each tree is cut in one op, face up, in a 4mm pocket of its own shape in an
    MDF plate: no flip, no back channel, pocket or exit slot. Each pixel hole is a
    19 x 2mm counterbore holding a printed 2mm disk (the bullet's clips grip it)
    and a 15mm clearance hole through. tools/gen_step.py writes the tree, fixture
    plate and assembly as STEP (CadQuery, optional) for CAM in NX; the SVG/DXF are
    front-only reference. fixtures/pixel-disk.scad: disk, plate of 20, test strip.
    The old-hole keep-out is measured from the clearance hole; 44 outline nodes
    move by up to 1.7mm.
    [fixture-plate.step, pixel-disk-test.stl, pixel-disk.scad, pixel-disk.stl, stair-tree-assembly.step, stair-tree-cnc-layout.dxf, stair-tree.step, step-clamp.scad]
2026-10-25 Track NX .prt files in cad/ (CAM setups live there); mark .prt binary
2026-10-25 CAD: NX parts with CAM setups (tree, fixture plate, assembly) and the clamp part + STEP
    [Clamp.prt, Clamp.stp, fixture-plate.prt, fixture-plate_step.prt, stair-tree-assembly_step.prt, stair-tree_step.prt, tree.prt]
2026-10-25 Effects: character moves for silent pieces (mouth shapes, eye moves, own outline looks)
    arrange_song: "moves" lay one character's mouth (phoneme or yawn/hum/giggle/chatter/
    whisper/snore/shush), eyes (look at a tree, up/down, closed, open, heavy, wink, roll...)
    and outline look over the sections; "brightness" dims a whole piece (not a sleeper's
    breath); "tree_end" puts trees out one by one. fx: glow, off, breathe (with a stagger
    down the line), bounce, swell, sparkle and ball looks; heavy and wink eye modes.
    Checked in xLights 2026.18: C_SLIDER_Brightness works on Faces and effects; Fill doesn't
    move without a value curve. check_render checks silent loops (mouths only open in a
    move, no outl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
    [arrange_song.py, check_render.py, fx.py, xsq.py]
2026-10-25 Silent loops: Waiting v2 (10 min of mucking about), Night, Morning, Lights Out
    tools/loops.py writes data/loops/: Waiting 1-10 (60 s scenes: Mexican wave, Noel
    showing off, pass the ball, Bramble nodding off, Ivy copying Holly, Jingle fidgeting,
    passers-by, the silent hum, colour relay, snow), Waiting Asleep 1-10 (the same with
    Bramble asleep), Night 1-8 (50 s, dim: yawns, peeking, poking, snore glow, giggles),
    Night Christmas Eve 1-3 (all asleep for Santa), Morning 1-6 (45 s: waking up, roll
    call, Bramble won't wake, Pip's sunrise, off to work), and the lead-outs Lights Out,
    Lights Out Asleep and Morning Lights Off (end black). All rendered and checked.
    The old one-piece Waiting arrangement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
    [loops.py]
2026-10-25 FPP: Night loop after the Goodnight with a 23:30 graceful backstop; Morning playlist; What's on page
    Loop playlists (Waiting, Waiting Asleep, Night, Night Christmas Eve, Morning) play their
    short pieces and have a lead-out, which FPP plays after a graceful stop. Night runs
    21:00-23:30 after every Goodnight (Christmas Eve: Night Christmas Eve), lowest priority
    but one, graceful stop; 00:00-00:30 on 1 January after the countdown; nothing after the
    season's last Goodnight. Morning isn't scheduled (Home Assistant starts it): repeat off,
    loopCount 1, its pieces listed for 3 hours, so it ends by itself through its lead-out.
    Read from FPP 10.3: a playlist stopped by hand isn't restarted in its wind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
    [fpp_bundle.py, gen_site_config.py, whats_on.py]
2026-10-26 Run - 1st off with adjsutments
    [fixture-plate.prt, stair-tree-assembly_step.prt, stair-tree-cnc-layout_dxf.prt, tree.prt]
2026-10-26 Counterbore 6mm deep (first-off CAM run); printed parts as STEP for NX
    - Params.front_counterbore_depth 2 -> 6 (Rob, after the first-off run in NX).
    The pixel disk is now 6mm: a 2mm front lip with the bullet bore (the clips
    still grip 2mm) and a 15mm relief behind it; it sits flush as before.
    CNC/STEP/DXF regenerated; docs say 6mm.
    - tools/gen_printed.py: every printed part as a STEP solid in cad/printed/ (as
    fitted) and cad/stair-tree-kit.step (tree, boots, pegs, tree box, 92 disks).
    Falls back to a less merged solid when face merging breaks one (left boot).
    - Boot source is now the left (control) boot, the right one mirrored; "fitted"
    export parts in the boot, box and clamp .sc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
    [boot-left.step, boot-right.step, peg-left.step, peg-right.step, pixel-disk-test.stl, pixel-disk.scad, pixel-disk.step, pixel-disk.stl]
2026-10-26 Power: one Mean Well LRS PSU per site inside the site box; WLED limits each tree to 2A
    Rob, 26 Oct 2026: no outdoor PSUs. The site box becomes a DRiBOX Large holding
    an enclosed, fanless LRS sized to the site (A LRS-200-12, B LRS-150-12, C/D
    LRS-100-12, at most 85% load) plus a spare LRS-200. Fuses move to DIN-rail
    10x38 holders. Each tree's WLED brightness limiter (ledma 25, maxpwr 2120 incl.
    WLED's 120mA ESP allowance, checked in the 16.0.1 source; it applies to DDP
    frames too) holds the pixels to 2A, so the load is 2.1A per tree.
2026-10-26 Site box is a DRiBOX Large; 2-pin bayonet connectors on every run; 2-core flex
    Rob, 26 Oct 2026. Brief, BOM, build guide, test checklist and electronics docs
    follow the one-LRS-per-site change: the PSU, DIN-rail 10x38 fuses, Pi, amp and
    (maybe) router on a printed plate (still to design) inside a DRiBOX Large; the
    mains lead goes only to the PSU's covered terminals. Each 12V run is 2-core
    0.75mm2 flex ending in a PY07 Z108 2-pin bayonet connector (socket on the run,
    pins on the tree's pigtail). The printed site box is kept but superseded.
    [gen_site_wiring.py]
2026-10-26 Spec locked for Site A: 3A fuses, router on the site PSU, stereo speakers
    Rob, 26 Oct 2026:
    - Every tree run and the player fused 3A (a tree can't exceed 2.3A; the PY07
    bayonet is ~4A); the router 2A, on the site PSU. PSU rule now <= 90% with
    every tree at its cap: Site A LRS-200-12 at 15.1A of 17A.
    - Stereo pair of outdoor 8 ohm speakers per site (Site A: PD BGO40, IP56).
    - Rob has an RCD outdoor socket at the site box.
    - BOM: LRS-200-12 at RS 106-5859 (215x115x30, GBP 30.56 ex VAT); generic
    RT18-32 DIN fuse holders; Pi 5 buck needs PSU_MAX_CURRENT=5000.
2026-10-26 BOM: Cudy WR3000 and microSD bought; Pi 5 boot medium (SD or NVMe) TBC
2026-10-26 Site A player is the Pi 3 (already set up as the bench FPP) on a Mini560; Pi 5 to Site B
    Rob, 26 Oct 2026: 10 Mini560s in hand cover 6 trees + the Pi 3 + 3 spare, so
    no buck or Pi 5 boot medium to buy for December. The webcam relay (planned on
    the Site A Pi 5) needs a rethink; noted in docs/webcam.md.
2026-10-26 December BOM trimmed to what Rob doesn't have (~GBP 175): blade fuse box, no spare PSU
    Rob, 26 Oct 2026: a 10-way blade fuse box with a negative bus replaces the DIN
    10x38 holders and the site box Wagos; no spare LRS-200 for December; he
    already has the mains lead, controller bits, PETG/glue/heatshrink and sheet for
    the fixture plate.
    [gen_site_wiring.py]
2026-10-26 BOM: controller board bits back on the December list (not bought yet)
2026-10-26 BOM: Rob has some of the flex; buy the balance
2026-10-26 Site A router indoors at the front window on its own adapter, Ethernet to the Pi
    Rob, 26 Oct 2026: about 5ft from the trees with its antennas upright, rather
    than in the DRiBOX (antennas flat over the PSU, at ground level). Per-site
    "router" setting in data/sites.json; Site A PSU back to 14.1A of 17A (83%);
    outdoor Cat6 added to the BOM; the 2A router fuse only where the router is on
    the PSU.
2026-10-26 BOM: speakers second-hand from eBay (GBP 20-40), BGO40 as the fallback
2026-10-26 BOM: speakers are the PD BGO40 pair (8 ohm, 89dB, IP56), specs confirmed
2026-10-26 BOM: fuse box ways (router is indoors)
2026-10-26 docs/wiring.html: Site A wiring drawings (connections, site box layout, tree box)
2026-10-27 Updated CAM programs
    [stair-tree-assembly_step.prt, stair-tree-cnc-layout.dxf]
2026-10-28 BOM: 27 Oct orders (WR3000 V2, BGO40 pair, Wagos, 50m H05RR-F, SP16/SP17 plugs); aviation plugs replace the PY07 bayonets
    [gen_site_wiring.py]
2026-10-28 docs/wiring.html: 27 Oct parts (SP17 connectors, H05RR-F flex, BGO40 pair, WR3000 V2); artifact v3
2026-10-28 Tree box: SP16 panel socket in the floor, firing down, for the 12V run (replaces the PG9 gland and pigtail)
    D hole 16.7 with a flat at 15.4 (listing: 16.5 / 15.3, M16x1.5 rear nut), flat
    towards the lid so it bridges when printed. The run's SP17 plug screws on from
    below inside the boot tower. Docs, wiring page (artifact v4) and site wiring
    updated; PG9s become spares. Which half carries the pins is still to check.
    [stair-tree-kit.step, tree-box-box-on-boot.step, tree-box-box.step, tree-box-box.stl, tree-box-lid-on-boot.step, tree-box-lid.step, tree-box-lid.stl, tree-box.scad]
2026-10-28 Tree box parts as STEP (cad/components, cad/tree-box-assembly.step) with fit checks
    tools/gen_components.py: every bought part in the tree box as a simple solid at its
    envelope (sizes in DIMS with source and status), placed as fitted, plus checks:
    roof thickness at the antenna, clashes, board stack. docs/tree-box-parts.md lists
    the sizes, sources and what to measure.
    Found: the floor sockets and the antenna nut sit on the rim ledge's slope
    (full-width inside only to y = 19.4); the roof is 11.1mm on the antenna axis
    against the bulkhead's 3.2mm max.
    [c1.step, esp32.step, header.step, mini560.step, pg7.step, protoboard.step, rpsma.step, sp16.step]
2026-10-28 Tree box: 40mm deep so the floor nuts clear the rim ledge; antenna through the outer side wall; fit coupon
    The parts check (tools/gen_components.py) found the SP16 and PG7 nuts sitting on the
    rim ledge's slope and the roof 11mm thick on the antenna axis (bulkhead max 3.2mm).
    Inside depth 30 -> 40 with the floor parts at y = 16 (assert guards the ledge);
    RP-SMA in the 2.4mm wall away from the tree's centre, above the board. Checks now
    clean: no clashes, 15mm spare above the ESP32. New tree-box-coupon.stl tries every
    hole and fixing in a short print. Left boot's tower follows the deeper box (boot
    redesign pending). Wiring page v5.
    [boot-left.step, rpsma.step, sp16.step, stair-tree-foot-left.stl, stair-tree-kit.step, tree-box-assembly.step, tree-box-box-on-boot.step, tree-box-box.step]
2026-10-28 Tree box redesign: base + cover on the back of the tree; no sockets; blended roof
    Rob, 28 Oct 2026: the box screws straight to the back of the tree (4 x 40 wood
    screws through side-flange slots and 10mm printed spacers; the boot is parked),
    and the electronics are built on a flat base rather than in the back of a box.
    - Base: an L (tree plate + shelf) carrying the board, the Mini560 standing on the
    board, the Wagos, and the SP16 + PG7 in the shelf. A 16mm plug round it carries
    one continuous cord groove (8mm bends down the sides).
    - Cover: back, sides and an 8-degree roof blended into the walls (flush sides,
    radius kept along the slope), slides on from behind; radial cord seal; 4 M3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
    [boot-left.step, esp32.step, header.step, mini560.step, sealed-box.scad, stair-tree-foot-left.stl, stair-tree-kit.step, terminal.step]
2026-10-29 NX: imported tree box parts and assembly
    [c1.prt, esp32.prt, header.prt, mini560.prt, pg7.prt, protoboard.prt, rpsma.prt, sp16.prt]
2026-10-30 Tree box redesign: L base + clip-on cover, blended and print-optimised
    The sliding cover would drag the cord out of its groove, so the box is now an
    L base carrying all the electronics, with the SP16, PG7 and RP-SMA firing down
    through the shelf. The cover hooks through two slots at the top, swings in and
    takes a single M3 at 45 degrees, which pulls it against the cord. The cord runs
    over the top and down the sides; the bottom is deliberately open.
    Outline blended for printing without supports. Fit checks and the assembly
    STEP updated, now with the spacers. Sizes from Rob's photo of 30 Oct.
    BOM: 30 Oct deliveries; the Cudy is a V1, not the V2 listed.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
    [esp32.step, mini560.step, rpsma.step, spacer.step, tree-box-assembly.step, tree-box-base.step, tree-box-base.stl, tree-box-coupon.stl]
2026-10-30 Site A PSU: S-400-12 with a printed terminal cover; no 12V on the controller board
    The S-400-12 (33A, 230V input, temperature-controlled fan) replaces the
    LRS-200-12 at Site A. New enclosure/psu-cover.scad, held by two M4 screws in the
    case's side holes, sized from photos. sites.json can now name a PSU in hand.
    The Mini560 stands on its OUT end on a 90 degree header and its IN end is wired
    from the Wagos, so the JP terminal goes. Board layout, assembly, BOM and docs
    updated. Wiring page redrawn for the L base tree box and republished.
    [mini560.step, psu-cover.scad, psu-cover.step, psu-cover.stl, terminal.step, tree-box-assembly.step]
2026-10-31 Controller board: fix the mirrored ESP32 headers
    The drawing had J2 on the top row with the antenna end to the left, a mirror
    image no real board can be fitted as. Rob's first board, built to the old list,
    put the GND wire on 3V3 and the 5V wire on CLK. J3 is now row 3 and J2 row 13,
    with a test that fails if it's ever mirrored again. Four joins move.
    [gen_controller.py]
2026-10-31 Tree box: wrap-round cover, M2 inserts; BOM: 31 Oct orders
    The first print couldn't be assembled: the lip under the shelf forced a straight
    push while the slot hooks needed a tilt, and the RP-SMA nut hit the cover's ramp.
    The cover now hooks over the plate's top edge along its length, with skirts round
    the top and sides, nothing under the shelf, and one M3 at 45 degrees. A search on
    the STL sections shows it goes on with no clash and no drag on the cord. Seal
    test and coupon reworked to match.
    Board standoffs take M2 heat-set inserts (Rob): 3.2mm hole, M2 x 6 machine screws.
    The hole is to be checked against the real inserts on the coupon.
    BOM records the CPC and AliExpress orders of 31 Oc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
    [tree-box-assembly.step, tree-box-base.step, tree-box-base.stl, tree-box-coupon.stl, tree-box-cover.step, tree-box-cover.stl, tree-box-params.scad, tree-box-seal-test.stl]
2026-10-31 WLED: program a tree controller over USB
    tools/wled_flash.py erases the ESP32, flashes WLED 16.0.1 with the install.wled.me
    layout, joins Wi-Fi over Improv serial, POSTs the tree's config and reads it back.
    Bench mode stays on DHCP; --site sets the fixed address. Images are SHA-256 pinned.
    It refuses the wreath, WLED_Star and WLED-SoundReactive.
    Wi-Fi details come from the environment or ~/.stairtree_wifi.json, never git.
    wled/provisioned.csv maps trees 1 to 9, all programmed 31 Oct, to their MACs.
    [provisioned.csv]
2026-10-31 NX: tree box parts and assembly for the wrap-round cover
    [c1134118.prt, c1541770.prt, esp32131607.prt, esp32539259.prt, mini560134235.prt, mini560541887.prt, pg7136021.prt, pg7543673.prt]
2026-11-01 Tidy: archive superseded NX imports, printed site box and one-off notes; design review
    - archive/: three old tree box NX imports (each set kept together), unused import
    parts, NX logs, the printed site box, morning-notes and show-folder-moves.
    archive/README.md says what each is; make_public leaves the folder out.
    - gen_printed no longer builds the site box; docs and links updated for the moves.
    - docs/design-review.md: findings of the 1 Nov review and the stale docs still to fix.
    [c1.prt, c1134118.prt, c1541770.prt, esp32.prt, esp32131607.prt, esp32539259.prt, fixture-plate_step.prt, header.prt]
